konaiahgari-nithish-reddy/base_text/edge-firmware-BaseCode/README.md

# SmartTrak Project

## Task Todo
- [x] Create Bare-Metal USB-CDC Class
- [x] Implement USB-CDC with master codebase
- [x] Create WiFi-Mesh Project (Working)
  - [x] Implement Mesh Fail Cases
  - [x] Implement MQTT Connection with Cloud
  - [x] Implement JSON parser
  - [x] Merge with Main Parser CodeBase

## Remote monitoring and Control implemented 
- [x] Get All Status data like (inclinometer, Polar Axis SPA Tracking Moves, Sun Angles, Motion Sensor Register values, PWM Register values)
- [x] Set parameters present in utility section --> Set Params
- [x] Corrected tracker and target angle
