konaiahgari-nithish-reddy/base_text/edge-firmware-BaseCode/Resources/Docs/SmartTrak Solar Panel Controller Diagrams A06 (1).pdf

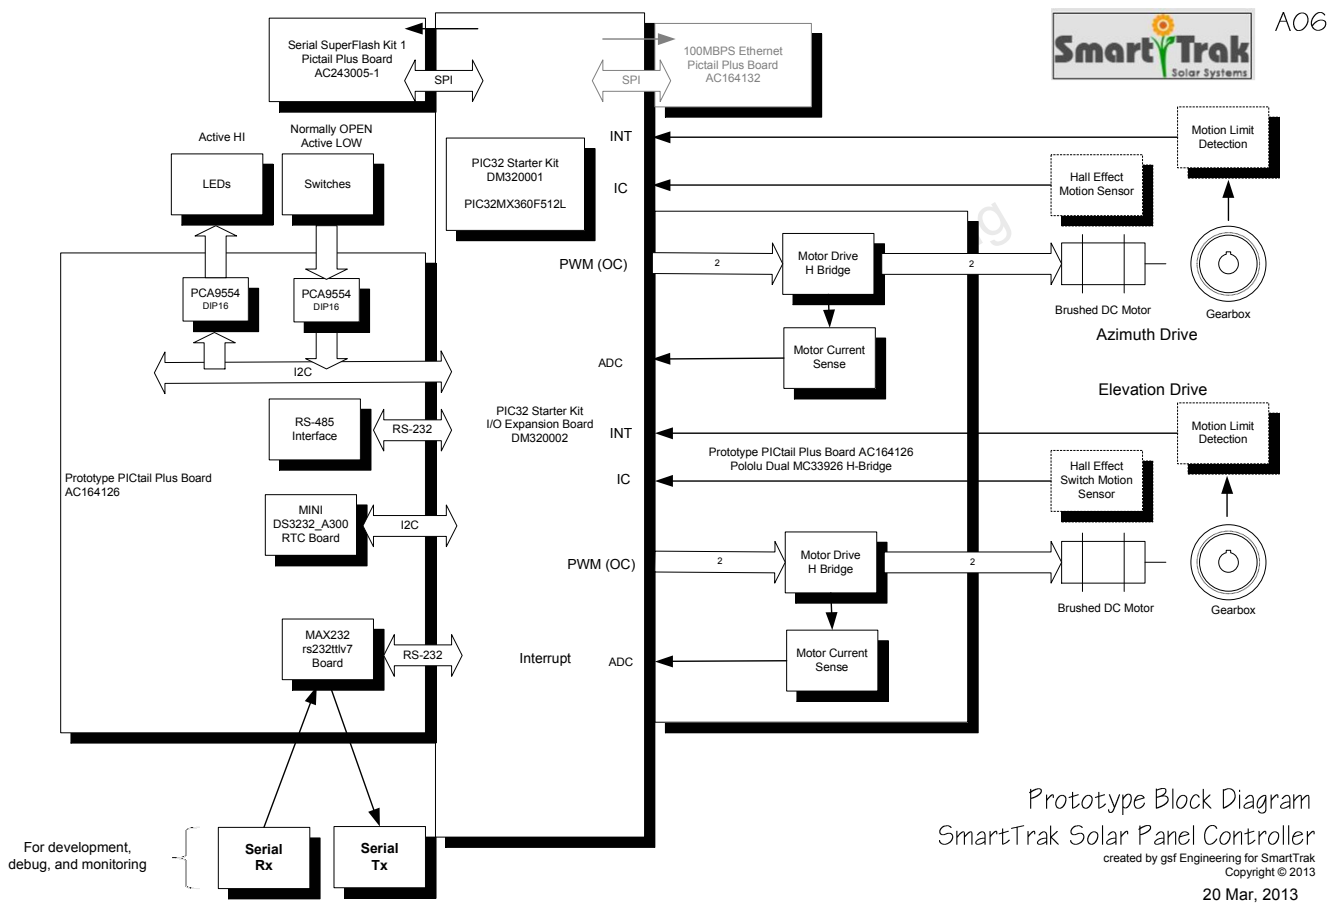
[picture p1: page 1]
20 Mar, 2013; Copyright © 2013; PIC32 Starter Kit I/O Expansion Board DM320002; Motor Drive H Bridge; Serial Rx; Serial Tx; Brushed DC Motor; Gearbox; Interrupt; Motor Current Sense; MAX232 rs232ttlv7 Board; Motion Limit Detection; ADC; Hall Effect Switch Motion Sensor; PWM (OC); Hall Effect Motion Sensor; PIC32 Starter Kit DM320001; PIC32MX360F512L; 100MBPS Ethernet Pictail Plus Board AC164132; MINI DS3232_A300 RTC Board; SPI; PCA9554; DIP16; Switches; LEDs; Normally OPEN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

Serial SuperFlash Kit 1
Pictail Plus Board

Confidential - Delete Before Reading

RS-232 RS-485 Interface

Prototype PICtail Plus Board AC164126
Pololu Dual MC33926 H-Bridge

Prototype PICtail Plus Board

For development,
debug, and monitoring

created by gsf Engineering for SmartTrak

# Confidential

# Delete Before Reading

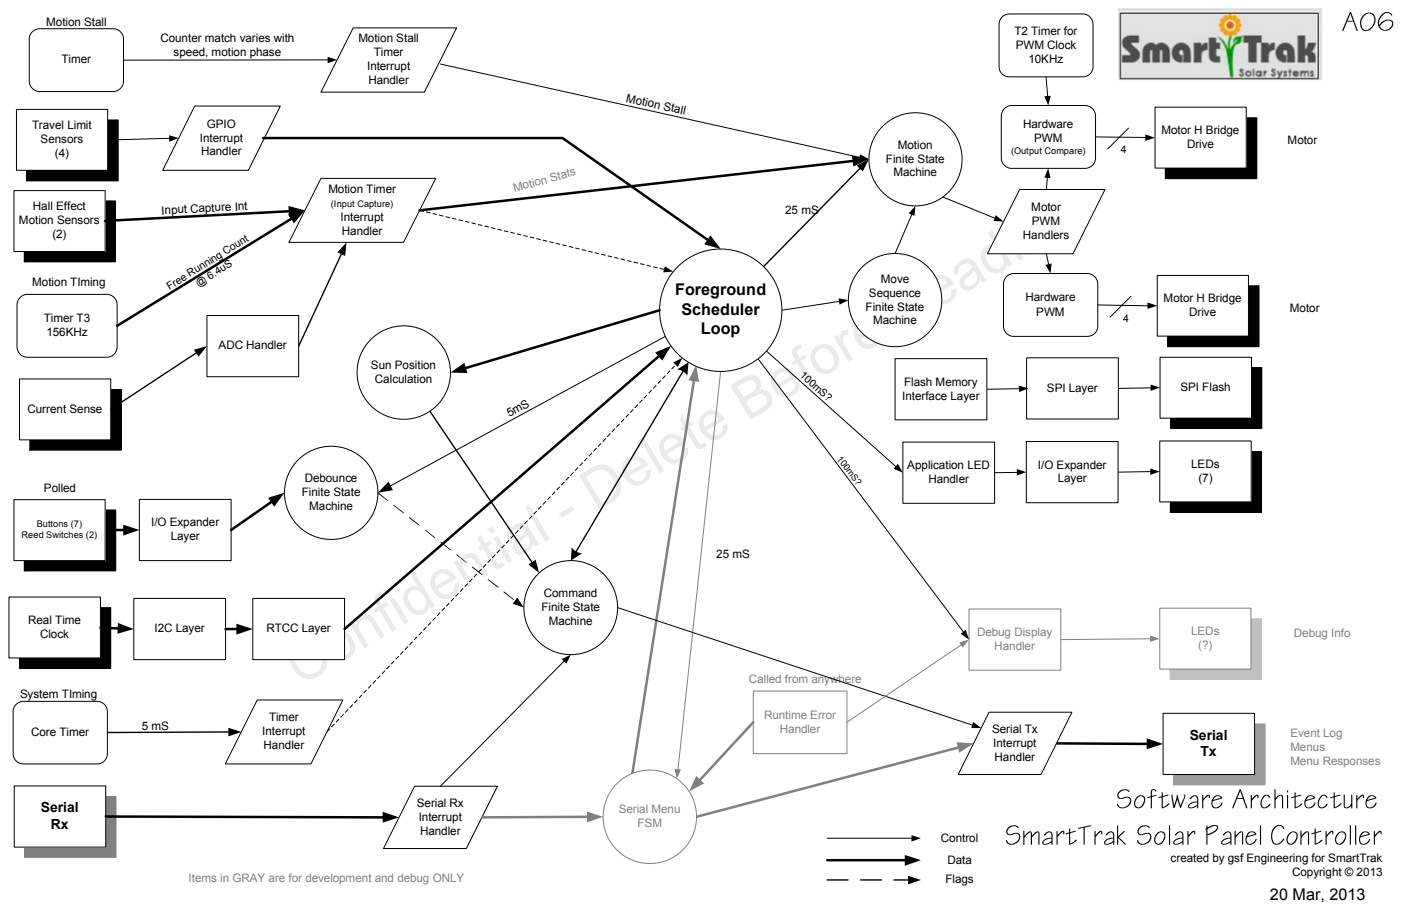
[picture p2: page 3]
Confidential; Motor H Bridge Drive; Timer T3 156KHz; LEDs (?); Debug Display; Debug Info; Handler; Data; Control; Flags; Debounce Finite State Machine; Buttons (7) Reed Switches (2); Core Timer; Timer Interrupt Handler; Hall Effect Motion Sensors (2); Motion Timer; (Input Capture) Interrupt Handler; pture Int; Motion Finite State Machine; Serial Rx Interrupt Handler; Serial Rx; Serial Tx; Event Log Menus Menu Responses; Hardware PWM; (Output Compare); Motor; Command Finite State Machine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

Counter match varies with
speed, motion phase

Delete Before Reading

Free Running Count

Called from anywhere

Items in GRAY are for development and debug ONLY

# Confidential - Delete Before Reading

Data

Control

Flags

Finite State
Machine

Interrupt
Handler

Internal
Hardware
Resource

External
Hardware

## Foreground Loop

Major Software
Routine (NOT FSM)

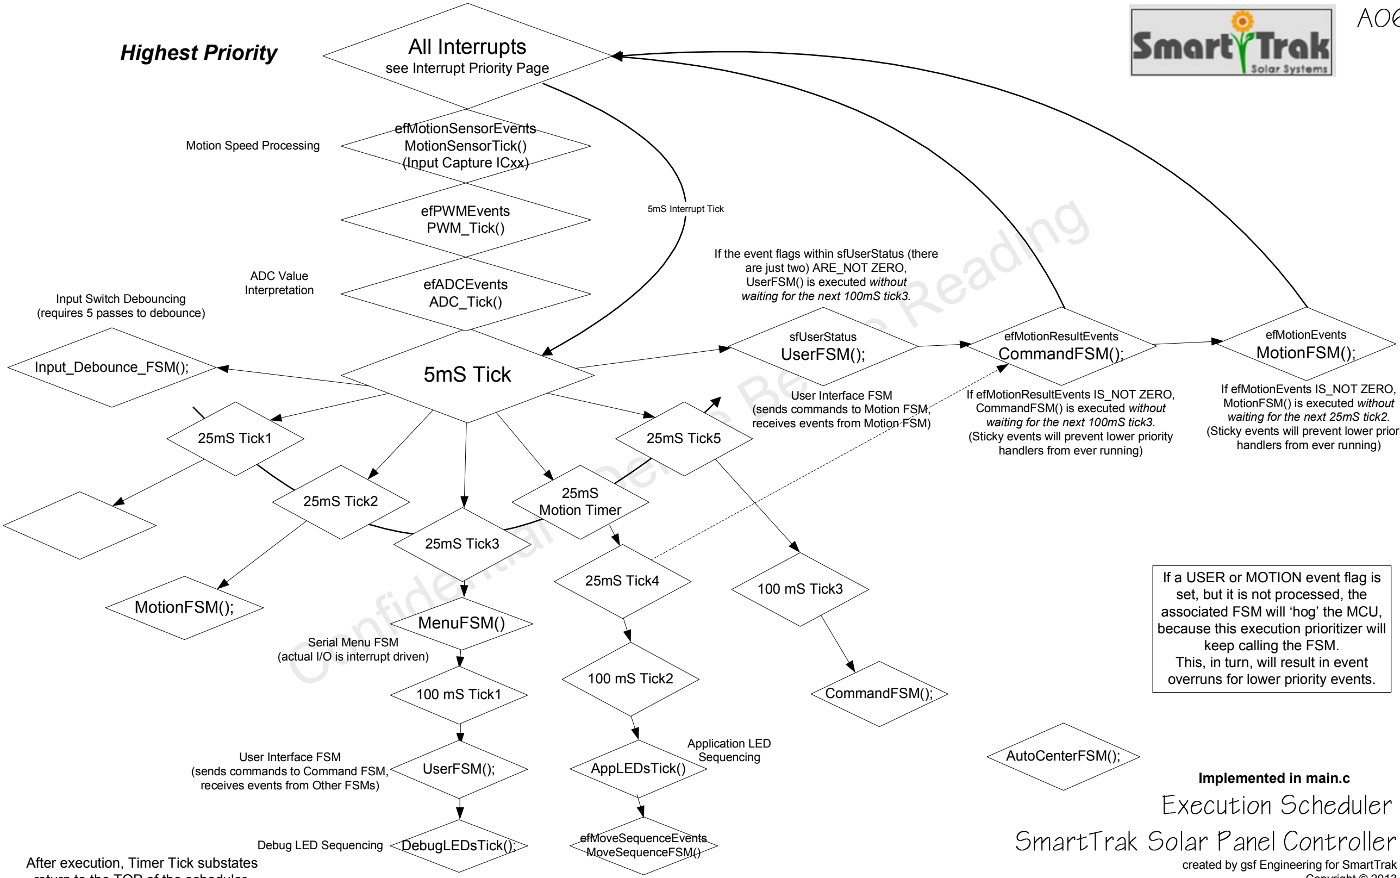
[picture p3: figure]
Confidential - Delete Before Reading; MenuFSM(); 5mS Tick; Serial Menu FSM (actual I/O is interrupt driven); 5mS Interrupt Tick; efADCEvents ADC_Tick(); efMotionEvents MotionFSM();; efMotionResultEvents CommandFSM();; ADC Value Interpretation; If efMotionEvents IS_NOT ZERO, MotionFSM() is executed without waiting for the next 25mS tick2.; handlers from ever running); If efMotionResultEvents IS_NOT ZERO, CommandFSM() is executed without waiting for the next 100mS tick3.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

Highest Priority | All Interrupts see Interrupt Priority Page

(Sticky events will prevent lower priority (Sticky events will prevent lower priority

return to the TOP of the scheduler.

If the event flags within sfUserStatus (there

# Confidential

# Delete Before Reading

STOPPED

Constant PWM
Constant Speed
‘Run’
STOPPED Increase PWM Accelerate | Decrease PWM Decelerate

Decrease
PWM
(Run)

HE Time
Too Short

At Target Speed,
(Maximum PWM)
OR
HE Count Complete

Accelerate Command

Total Motion Sensor Ticks required for requested Move

Total Motion Sensor Ticks required for requested Move MINUS Ticks required for Deceleration and STOP

Constant Speed
Motion Complete
(HE Count Complete)

Motion Complete
(HE Count Complete)

Move Specification:
Distance in Motion Sensor Ticks
Maximum (constant) Speed, not a variable

Input Parameters:
PWM Width

Measured Ouputs:
Time between Motion Sensor ticks (Speed)

Decrease
PWM
(Acceleration)

HE Time
Too Short

Hard STALL

Minimum PWM
Constant Speed

Minimum PWM
Stalled

Minimum PWM
Stalled

Minimum
PWM

Motion Stall
Stalled

Motion NOT Complete Acceleration NOT

Complete
Constant Speed Motion
NOT Complete

Deceleration to Minimum PWM NOT Complete

### Speed

FSM Parameters:
Initial PWM width
Acceleration in PWM width change per timer interrupt
Number of Motion Sensorticks during acceleration (may not be enough to reach max speed)
(Needs to account for current travel limit)
Final PWM width at end of acceleration (maximum PWM)
Number of Motion Sensor ticks during constant speed (may be 0) (Needs to account for travel limit)
Deceleration in PWM width change per timer interrupt
Number of Motion Sensor ticks during deceleration
(Needs to account for travel limit)
Minimum PWM width at end of deceleration

External FSM Events
New Motion Command

Init

Initialization

Increase PWM
(Acceleration)

HE Time
Too Long

Increase PWM
(Run)

HE Time
Too Long

Recovered,
At End Stop

Stalled - ERROR

### States shown in GREEN are the actual motion control code, which

corrects motion (speed) errors.

### Implemented in MotionFSM.c

No Constant Speed
Run Phase

Coasting
Braking | Motion Stall

Motion Complete
(HE Count Complete)

Soft STALL
FSM

Motion Stall
OR
Maximum PWM

Motion Stall
Stalled

Motion Stall
Stalled

Motion Stall
Stalled

Note: we cannot detect the end-stop during Coasting/
Braking because the
ONLY exit from the state
is.. A MOTION_STALL!

Note that there are no motion control adjustment states for Deceleration

Notes:
Speed is measured by timing Motion Sensor Ticks
Distance is measured by counting Motion Sensor Ticks
To bring about a controlled stop at ANY time, change the number of Ticks to Move to ZERO

Initial (minimum) PWM value must be determined
experimentally

Total Motion Sensor Ticks required for requested Move

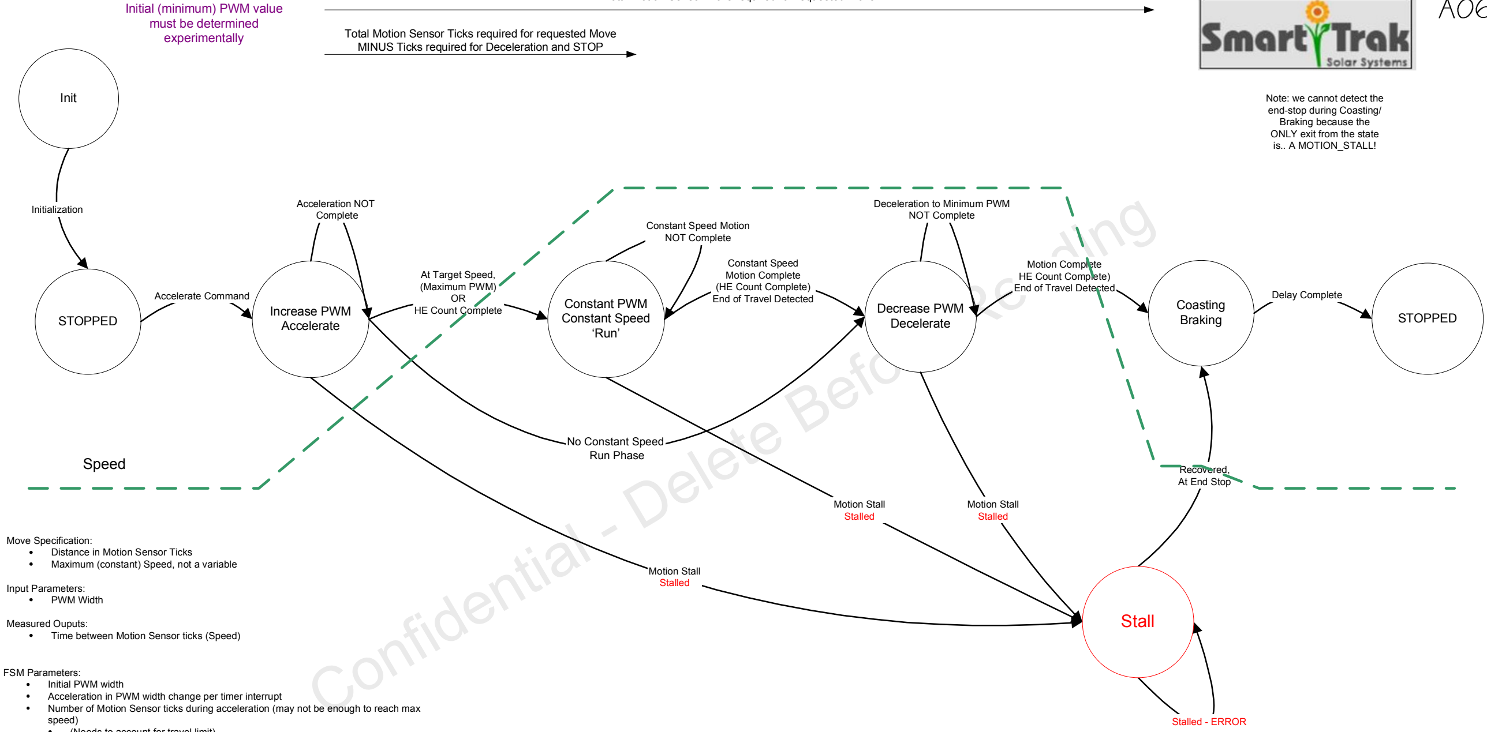
[picture p4: figure]
Confidential - Delete Before Reading; STOPPED; Constant PWM Constant Speed ‘Run’; STOPPED Increase PWM Accelerate; Decrease PWM Decelerate; At Target Speed, (Maximum PWM) OR HE Count Complete; Accelerate Command; Constant Speed Motion Complete (HE Count Complete) End of Travel Detected; Move Specification: Distance in Motion Sensor Ticks; Input Parameters: PWM Width; Measured Ouputs:; Acceleration NOT Complete; Constant Speed Motion NOT Complete; Deceleration to Minimum PWM NOT Complete; Speed; FSM Parameters: Initial PWM width; speed); Init; Initialization; Recovered, At End Stop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

Total Motion Sensor Ticks required for requested Move MINUS Ticks required for Deceleration and STOP

Maximum (constant) Speed, not a variable

Time between Motion Sensor ticks (Speed)

Notes:
Speed is measured by timing Motion Sensor Ticks
Distance is measured by counting Motion Sensor Ticks
To bring about a controlled stop at ANY time, change the number of Ticks to Move to ZERO

Acceleration in PWM width change per timer interrupt
Number of Motion Sensor ticks during acceleration (may not be enough to reach max

(Needs to account for travel limit)
Final PWM width at end of acceleration (maximum PWM)
Number of Motion Sensor ticks during constant speed (may be 0) (Needs to account for travel limit)
Deceleration in PWM width change per timer interrupt
Number of Motion Sensor ticks during deceleration
(Needs to account for travel limit)
Minimum PWM width at end of deceleration

External FSM Events
New Motion Command

### Implemented in MotionFSM.c

# Confidential - Delete Before Reading

### Acceleration

### Deceleration (¼ acceleration distance)

Constant Speed ‘Run’

## Long Move

## shortest Possible Move

Coast Brake

Stopped

# Speed

# Distance

# NOT TO SCALE!

## Shortest Useful Move

## Run to End-of-Travel

### Ends with End-of-Travel Detection

Coast

Brake Stopped

### Deceleration (¼ acceleration distance)

Coast

Brake Stopped

### Deceleration (¼ acceleration distance)

### Acceleration

### Acceleration

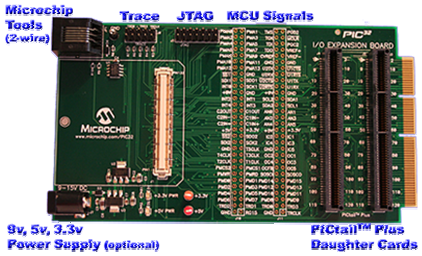
[picture p5: figure]
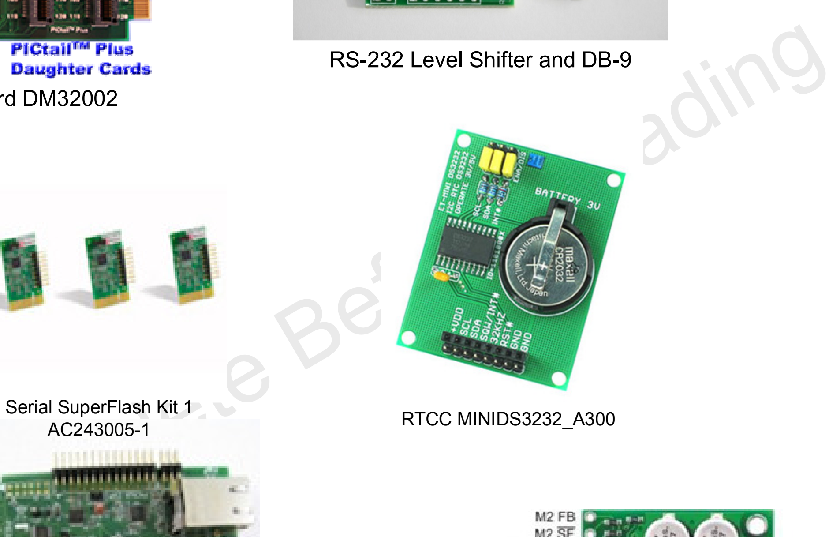
[picture p6: figure]
Delete Before Reading; RS-232 Level Shifter and DB-9; Serial SuperFlash Kit 1 AC243005-1; RTCC MINIDS3232_A300
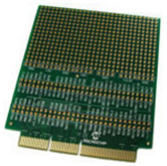
[picture p7: figure]
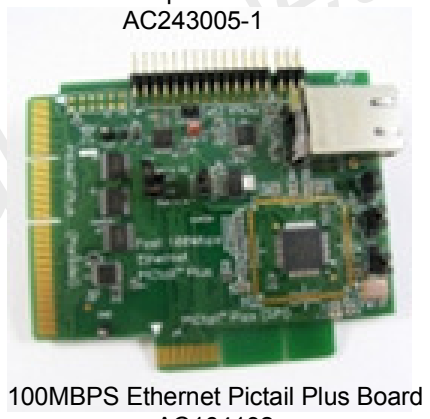
[picture p8: figure]
100MBPS Ethernet Pictail Plus Board

# Confidential

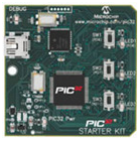
[picture p9: figure]

### PIC32 Starter Kit DM32001 PIC32 Starter Kit I/O Expansion Board DM32002

Prototype PICtail Plus Board
AC164126

AC164132

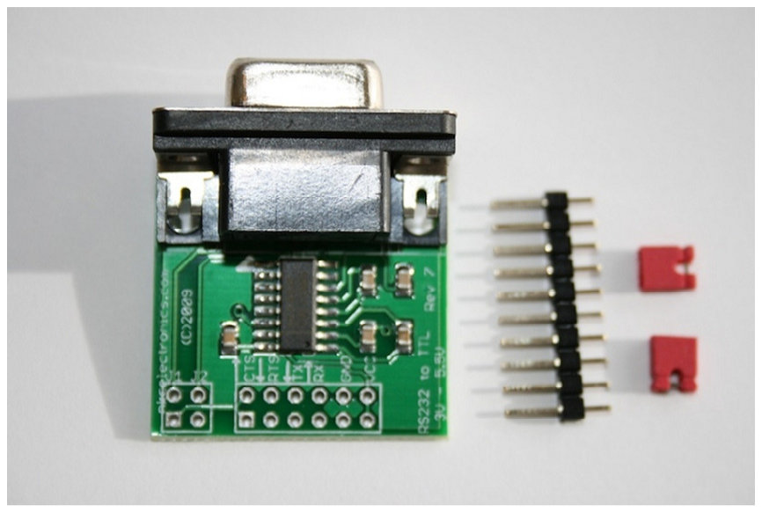
[picture p10: figure]
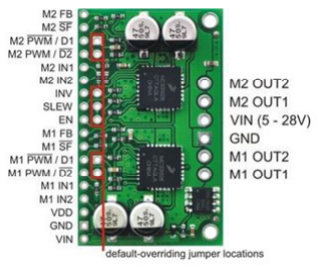
[picture p11: figure]

### Pololu Dual MC33926 H-Bridge

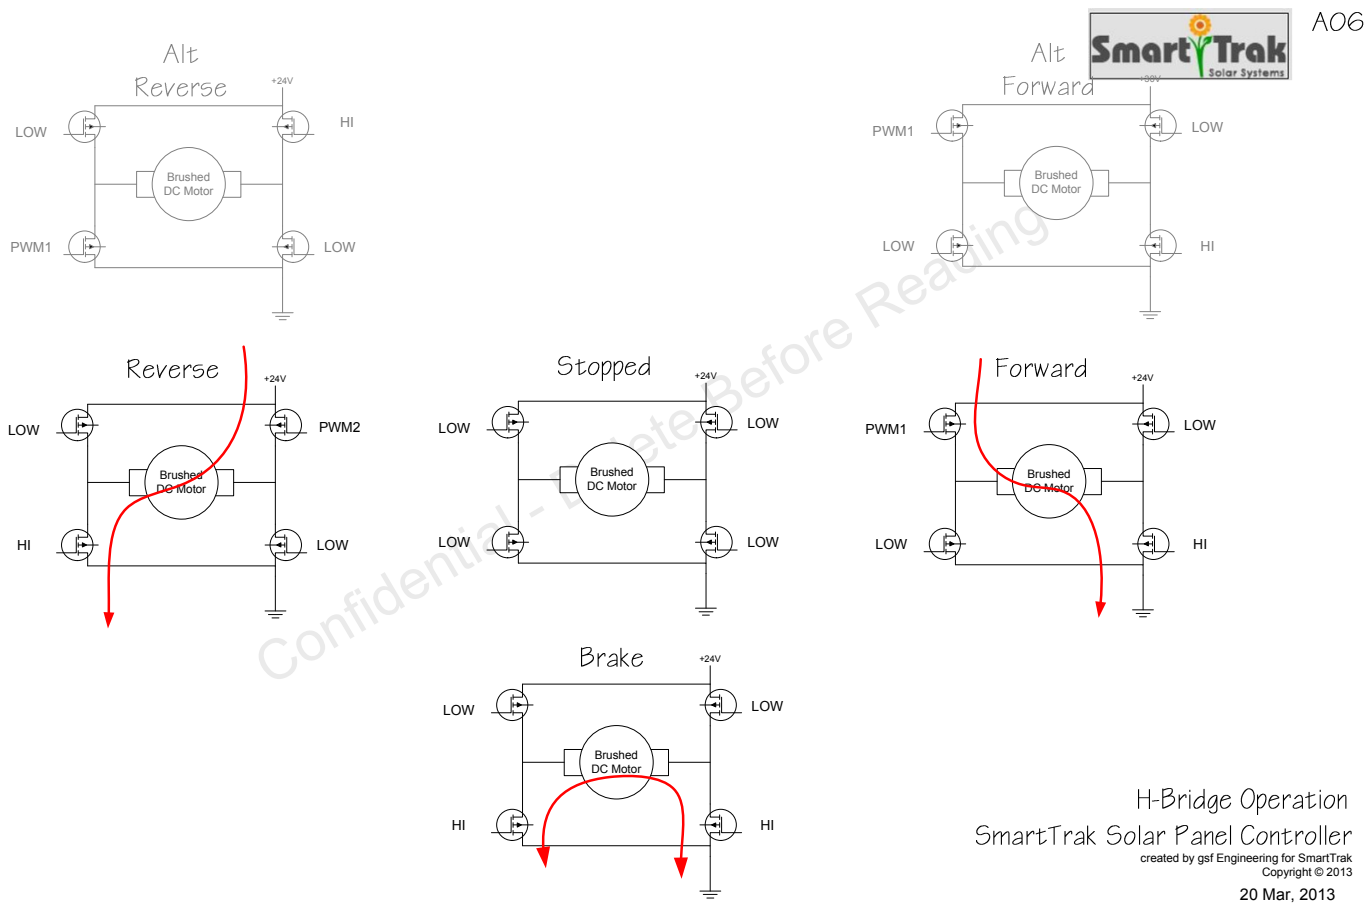
[picture p12: page 10]
Brushed DC Motor; LOW; PWM2; PWM1

Confidential - Delete Before Reading

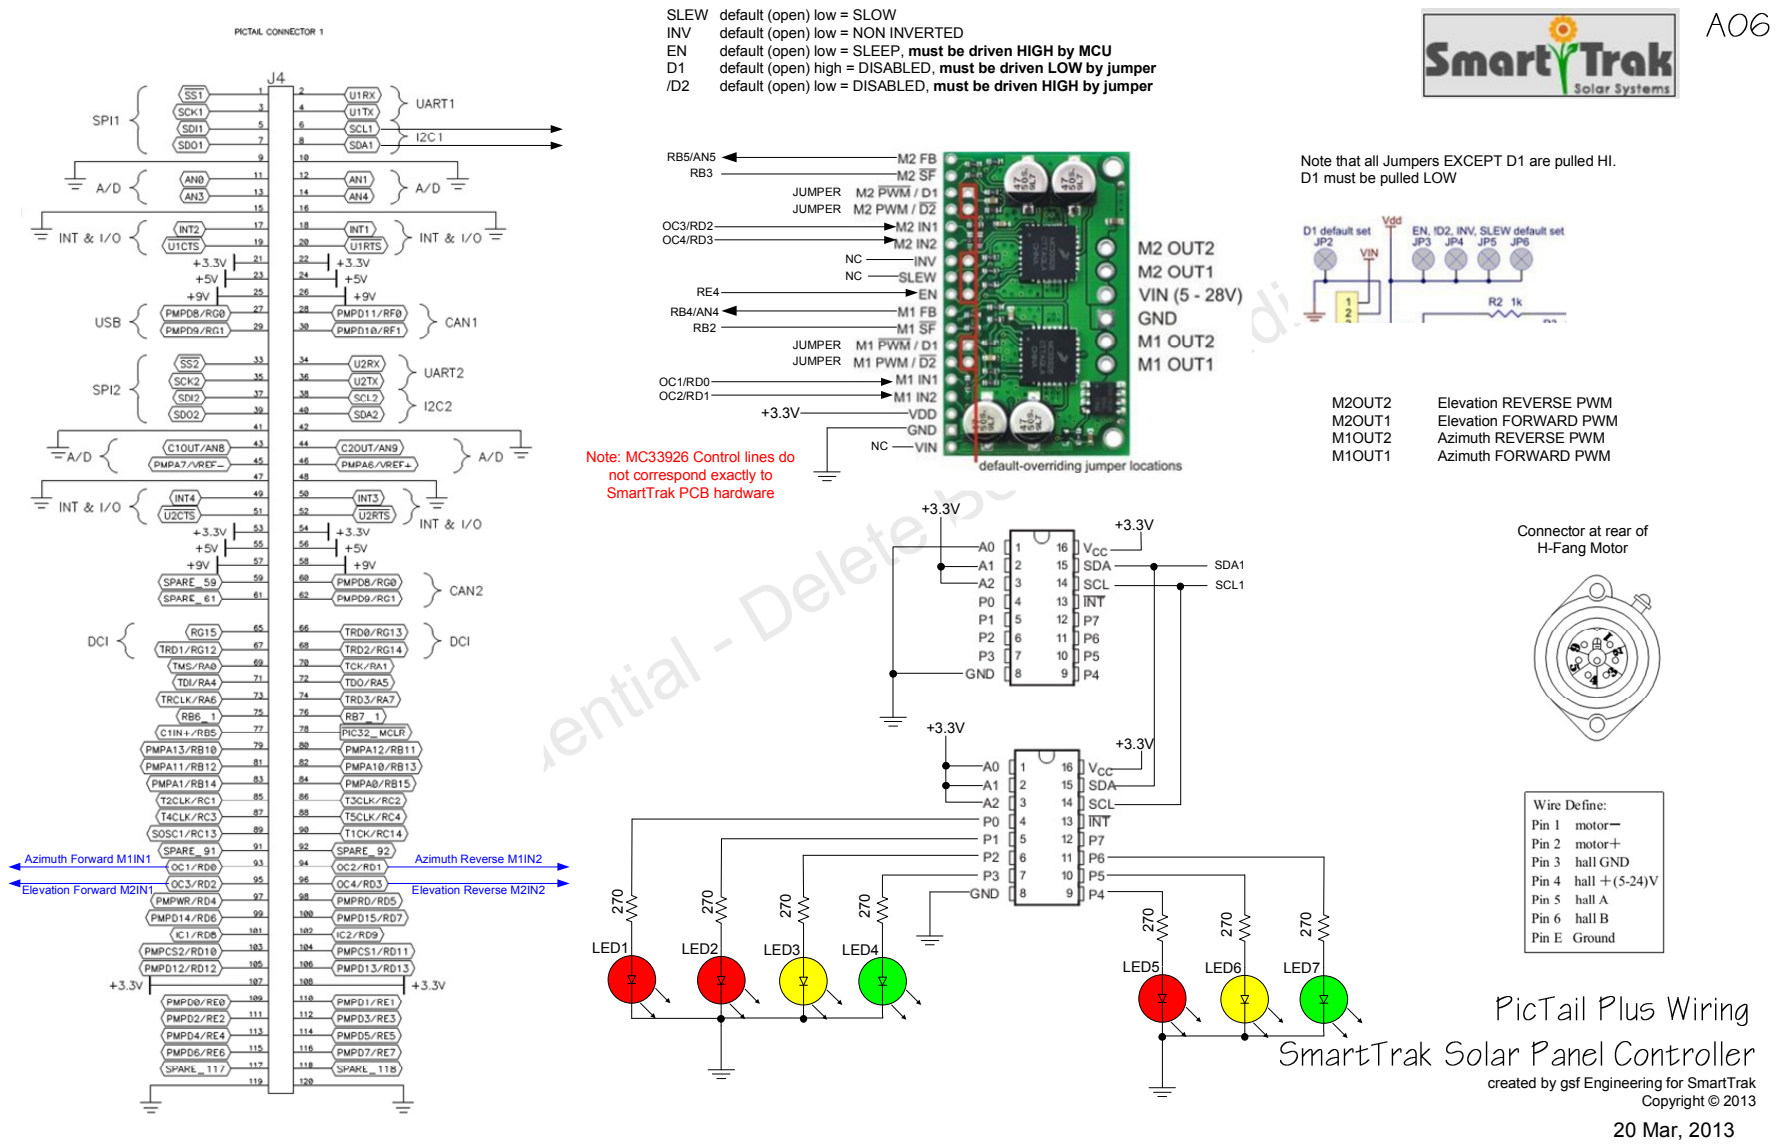
[picture p13: page 11]

SLEW default (open) low = SLOW

Note that all Jumpers EXCEPT D1 are pulled HI.
D1 must be pulled LOW

Confidential - Delete Before Reading

Note: MC33926 Control lines do
not correspond exactly to
SmartTrak PCB hardware

Connector at rear of
H-Fang Motor

Note that all Jumpers EXCEPT D1 are pulled HI. D1 must be pulled LOW

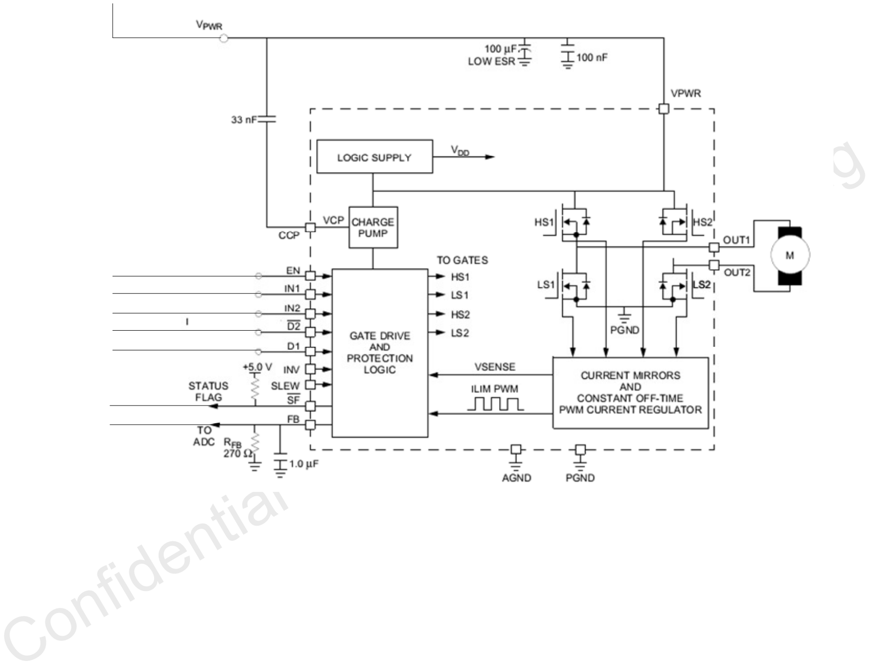
[picture p14: figure]
Confidential - Delete Before Reading
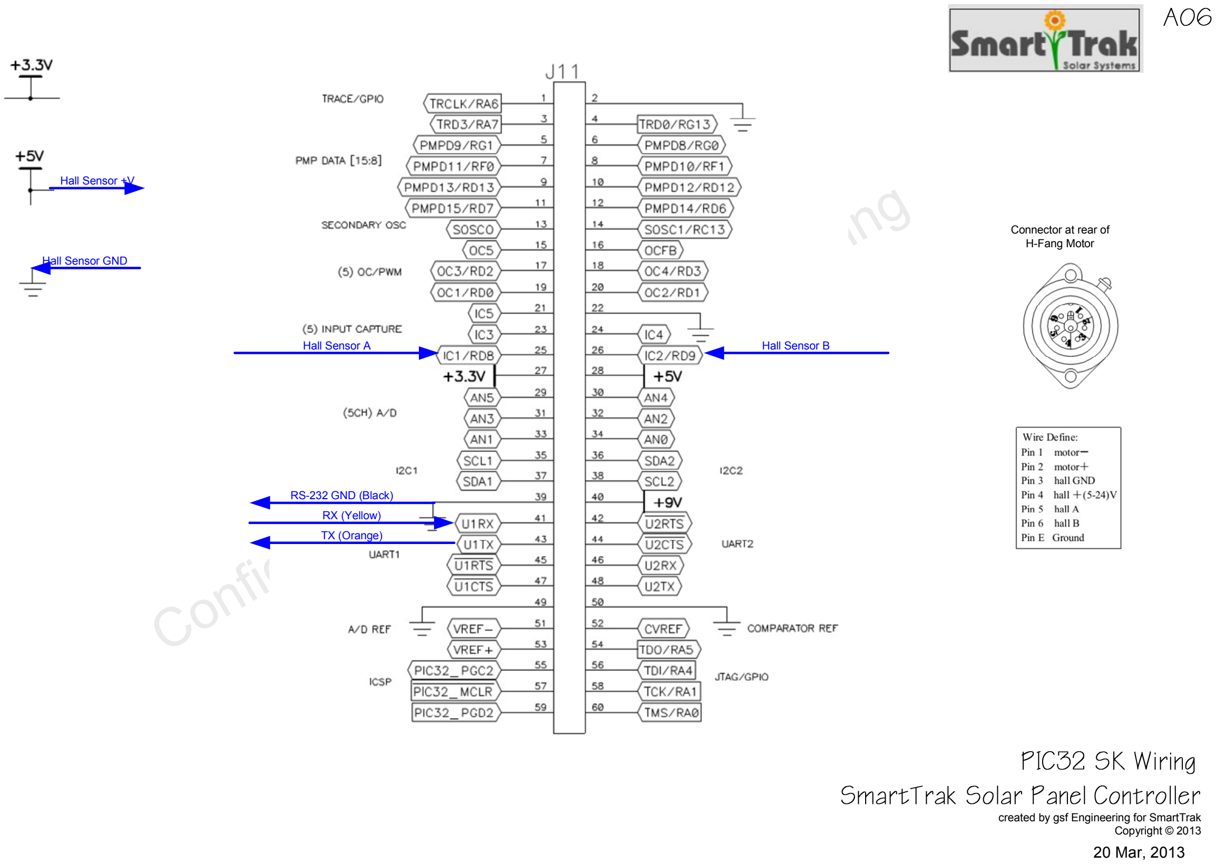
[picture p15: page 13]

# Confidential

# Delete Before Reading

TX (Orange)

RX (Yellow)

RS-232 GND (Black)

Hall Sensor A | Hall Sensor B

Hall Sensor +V

Hall Sensor GND

Connector at rear of
H-Fang Motor

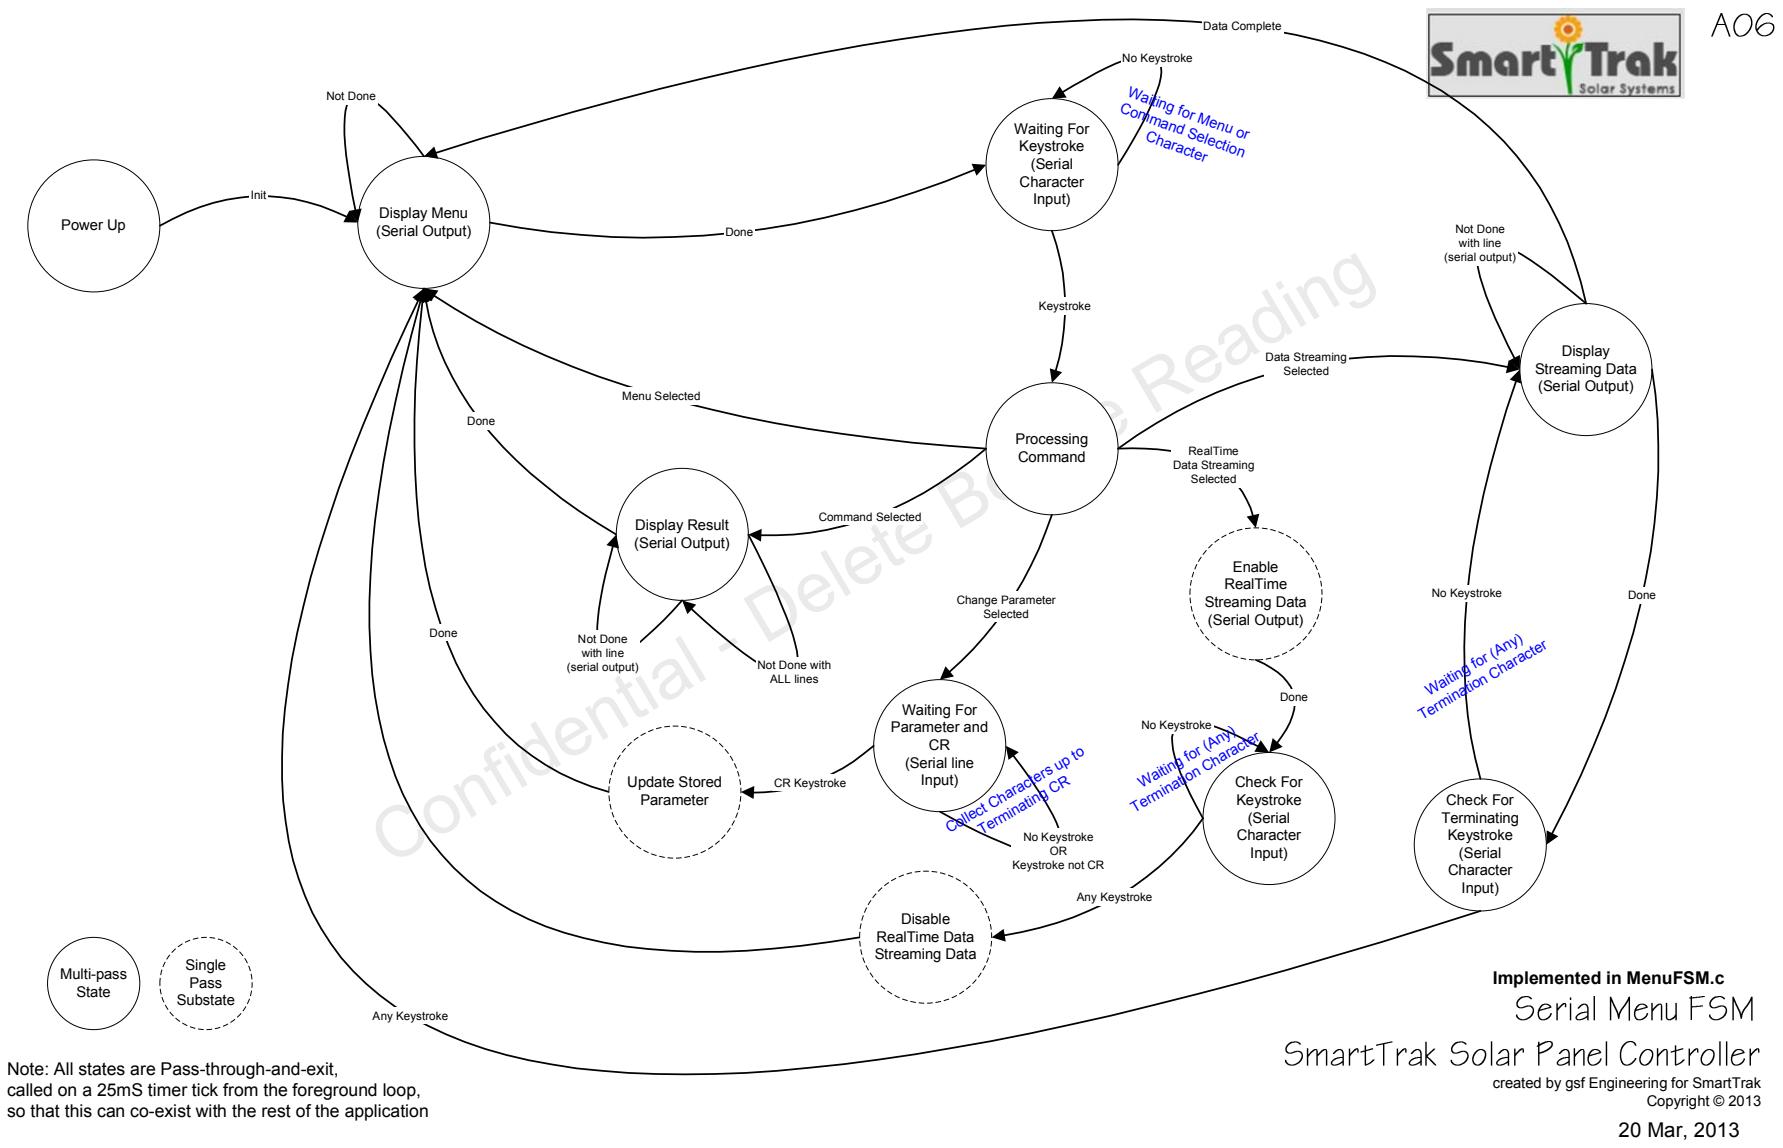
[picture p16: page 14]
Power Up; Display Menu (Serial Output); Waiting For Keystroke (Serial Character Input); Waiting For Parameter and CR (Serial line Input); Processing Command; Init; Done; No Keystroke; Menu Selected; Keystroke; No Keystroke OR; Change Parameter Selected; Not Done; Display Result (Serial Output); Not Done with line (serial output); Command Selected; Data Streaming Selected; Check For Terminating Keystroke (Serial Character Input); Display Streaming Data (Serial Output); Any Keystroke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

Waiting for Menu or Command Selection Character

Confidential - Delete Before Reading

Waiting for (Any)

Not Done with
ALL lines

Collect Characters up to Terminating CR

Keystroke not CR

Implemented in MenuFSM.c

Note: All states are Pass-through-and-exit,
called on a 25mS timer tick from the foreground loop,
so that this can co-exist with the rest of the application

# Confidential

# Delete Before Reading

### Planetary Gearbox

575:1

Max Motor Gearbox Velocity: 18.8 degrees/sec 30 motor revolutions/sec (1800 RPM) 3.13 output shaft revolutions/min (1127 degrees/min) 0.0522 output shaft revolutions/sec (18.8 degrees/sec) 60 Motion Sensor ticks/sec 16.7mS per Sensor tick (0.31 degrees/tick) TMR3 = (80MHz/2)/256, 156KHz, 6.40uS/count 5219 TMR3 counts per Motion Sensor tick Max Acceleration: x.xxx degrees/s/s assuming linear acceleration from 0 to x.xxx degrees/s/s x.xx shaft revolutions xx.x motor revolutions xxxx Motion Sensor ticks

### Motion Sensor (Hall Effect) 2 ticks per MOTOR revolution

1.00 degree Total Motion: 0.0028 output shaft revolutions 0.2028 input shaft revolutions 116.6 motor revolutions 233.2 motion sensor ticks 0.065 minutes, 3.89S at maximum speed (no accel or decel) Minimum motion 0.00429 degrees 0.5 motor revolutions 1 Motion Sensor tick TOTAL Longest Motion Sensor tick timing: accelerating from 0 at 9.4 degrees/s/s using d = 0.5 * a * t ^2, for d = 4.7 degrees, t = 1.0S xxxxx TMR3 counts per motion sensor tick xx.xx times longer than the 16.7mS tick at max spee

d

### this time, which is not entirely accurate because we will start with at least 20% duty cycle, will nonetheless be used to

determine the maximum motion timeout value

### Motor Kv 83 rpm/V (Measured) No Load 1800 RPM

0.0028 Output Shaft Revolutions Motion Profile 233 Motion Sensor Wheel ticks TOTAL 58 ticks accelerating from 0 at 9.4 degrees/s/s using d = 0.5 * a * t ^2, for d = 4.7 degrees, t = 1.0S 58 ticks decelerating at 2.35 degrees/s/s (1:4) using d = 0.5 * a * t ^2, for d = 4.7 degrees, t = 2.0S 117 ticks at full speed, 16.7mS per tick

t = 1.95S

### for a total 4.95S move observed x.xxS move starting at 20% duty cycle

Note: these timing calculations are based on starting motion at 0% PWM, and ramping up from there.
In reality, we will start the PWM will be started at 20% (or higher), which makes the calculations more complicated, and better done with a spreadsheet - but this method of calculation provides worst-case timing.

# Mechanical Characteristics Travel Limits:

### PWM is set by a 16 bit value, so the PWM can

be adjusted on every Motion Sensor tick.

### PWM drive at 10KHz (arbitrarily selected) Starting PWM value 20%, based on prior experience

### 1.00 Degree Move (This is an example, final specs not determined)

### Slew Gearbox

73:1

### Total Required Motion 16 Degrees/hour 16 x 1.0 Degree Move 16 x 4.95S = 79.2S in a 3600S hour

# To Be Corrected from Spreasheet
