konaiahgari-nithish-reddy/base_text/edge-firmware-BaseCode/Resources/Docs/NDA and Requirement/9-1_tracker-details.png

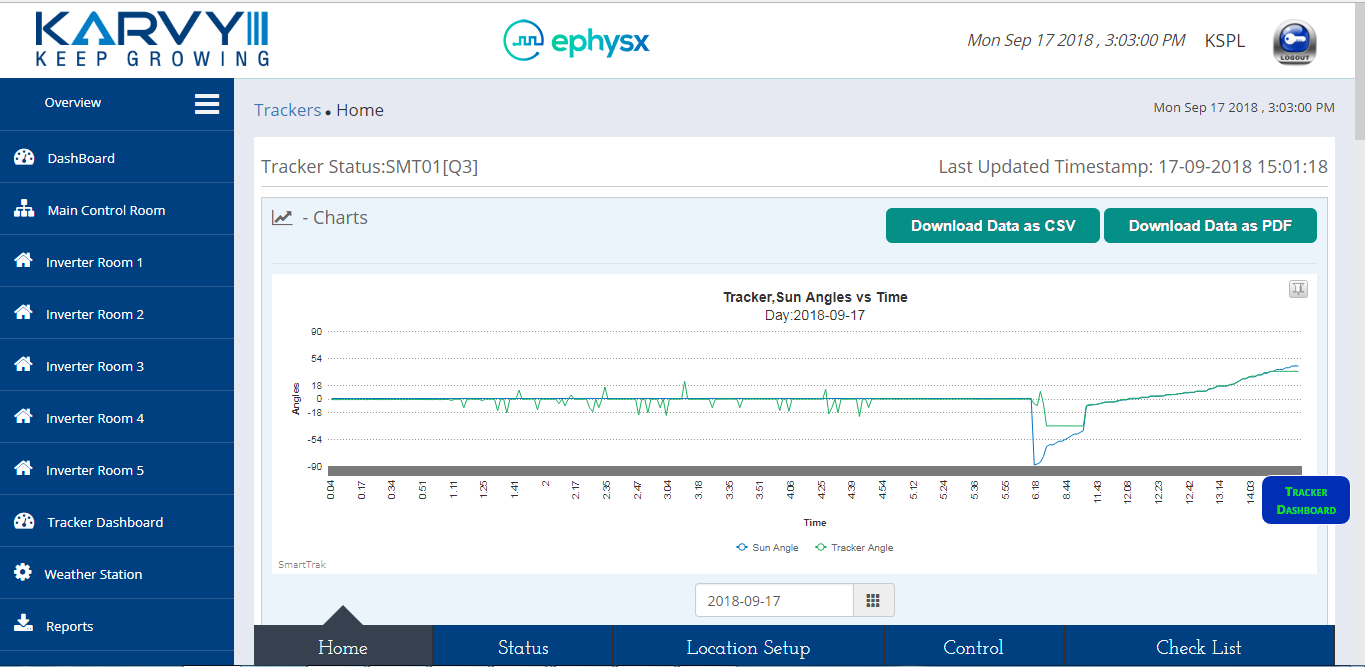
edge-firmware-BaseCode/Resources/Docs/NDA and Requirement/9-1_tracker-details.png
