konaiahgari-nithish-reddy/base_text/edge-firmware-BaseCode/Resources/Docs/NDA and Requirement/9-2_tracker-status.png

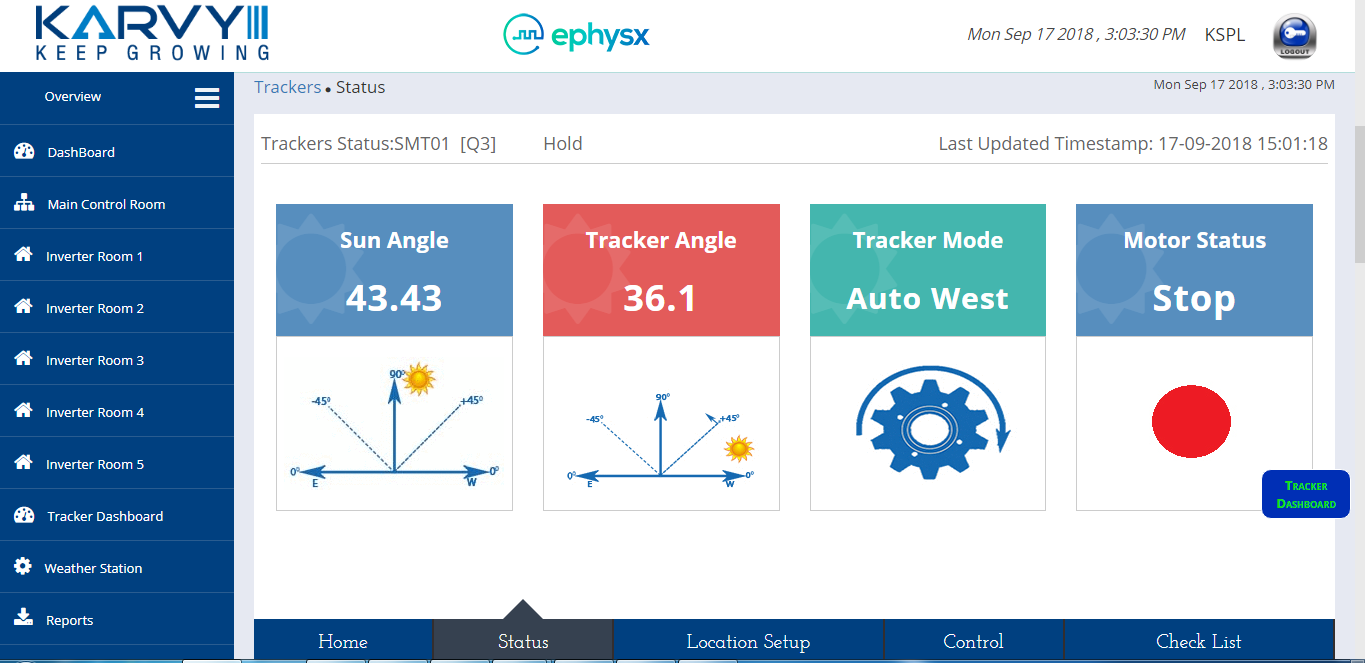
edge-firmware-BaseCode/Resources/Docs/NDA and Requirement/9-2_tracker-status.png
