konaiahgari-nithish-reddy/base_text/edge-firmware-BaseCode/Resources/Docs/NDA and Requirement/9-4_tracker-control.png

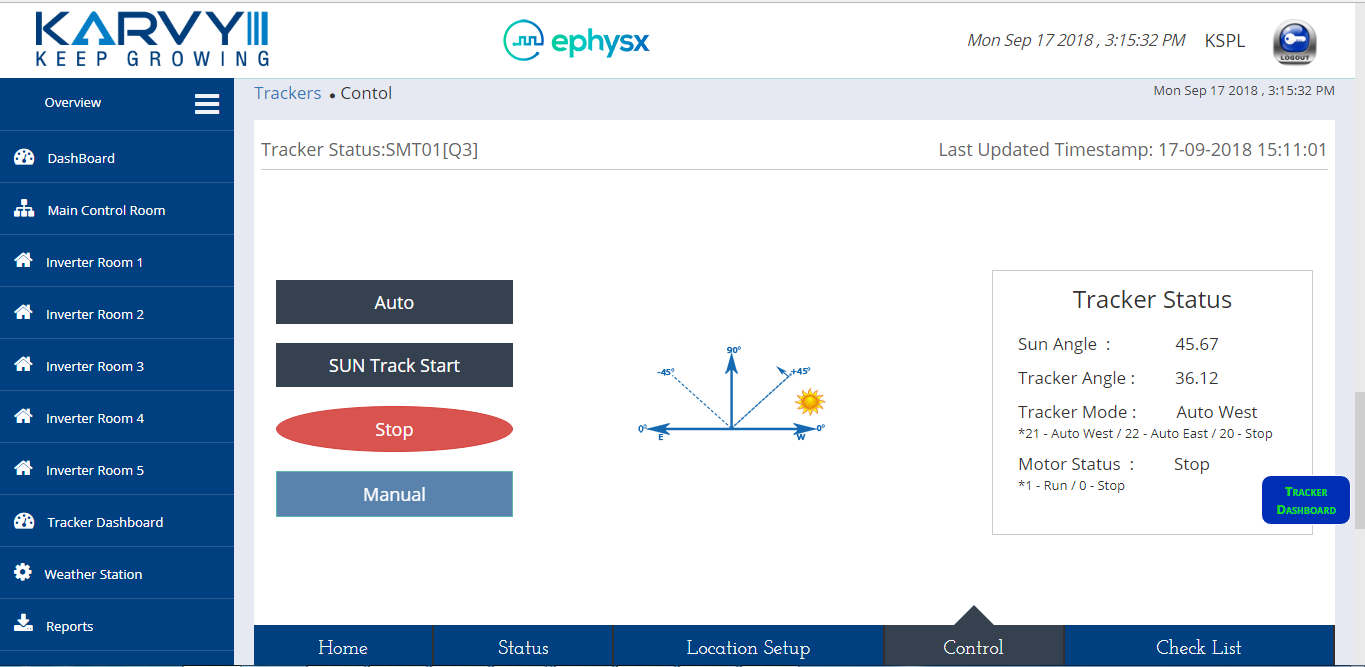
edge-firmware-BaseCode/Resources/Docs/NDA and Requirement/9-4_tracker-control.png
