konaiahgari-nithish-reddy/base_text/edge-firmware-BaseCode/Resources/Docs/NDA and Requirement/9_trackers_details.png

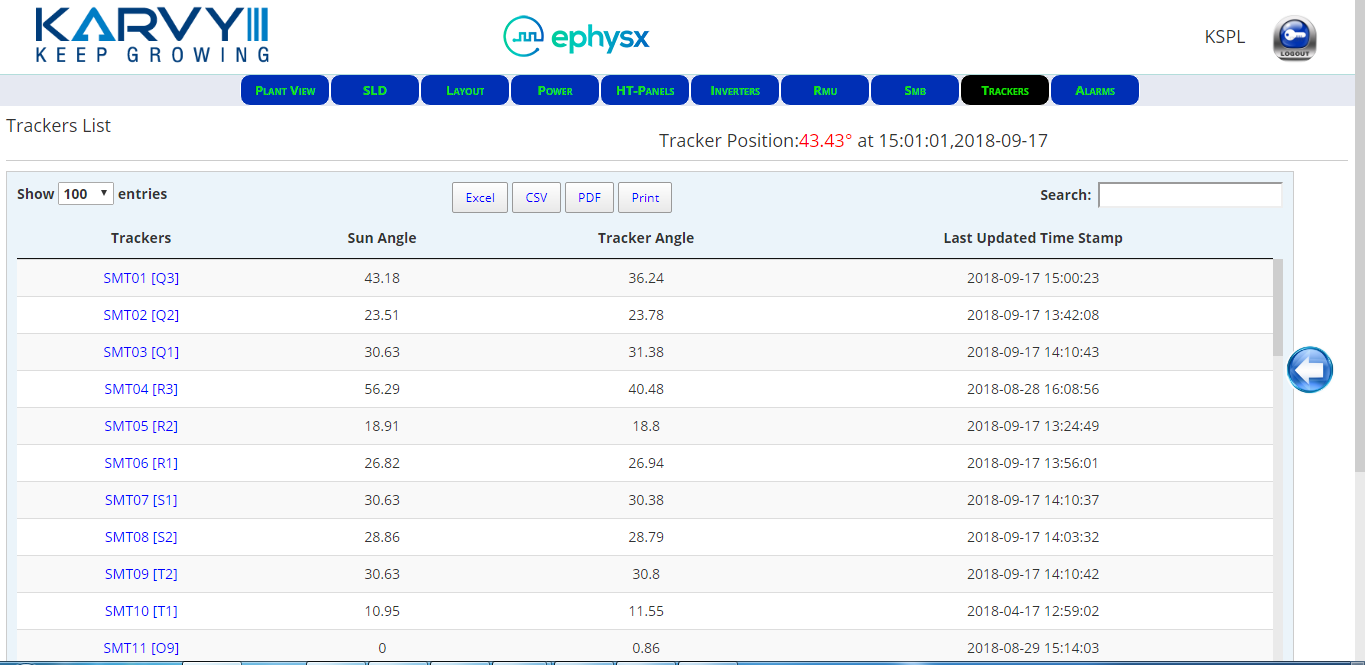
edge-firmware-BaseCode/Resources/Docs/NDA and Requirement/9_trackers_details.png
