konaiahgari-nithish-reddy/base_text/edge-firmware-BaseCode/Resources/Docs/USB_Device_initialization_main_functions_call_graph.png

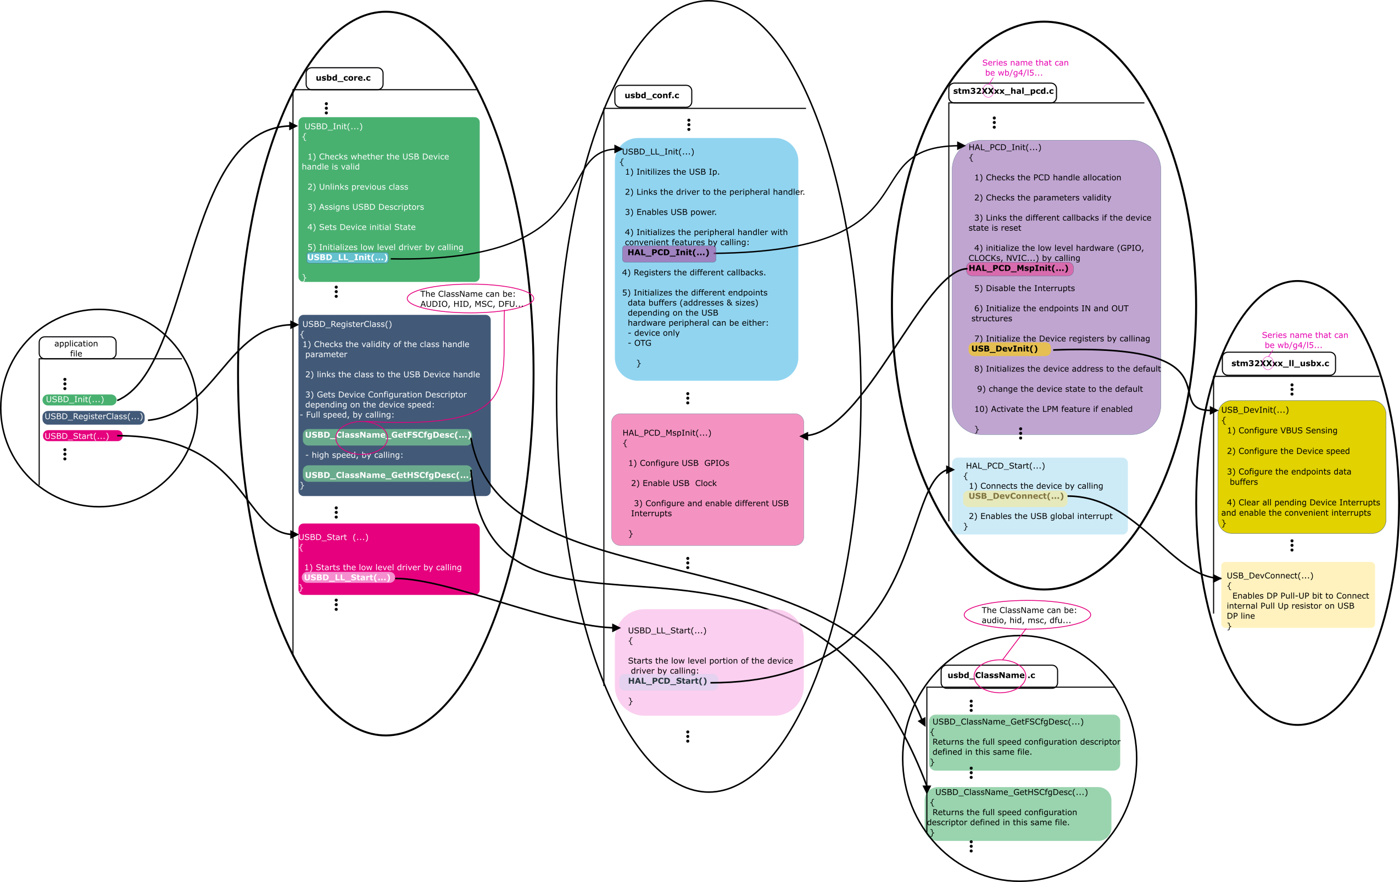
edge-firmware-BaseCode/Resources/Docs/USB_Device_initialization_main_functions_call_graph.png
