konaiahgari-nithish-reddy/base_text/edge-firmware-BaseCode/Resources/Docs/NDA and Requirement/9-3_tracker-location-setup.png

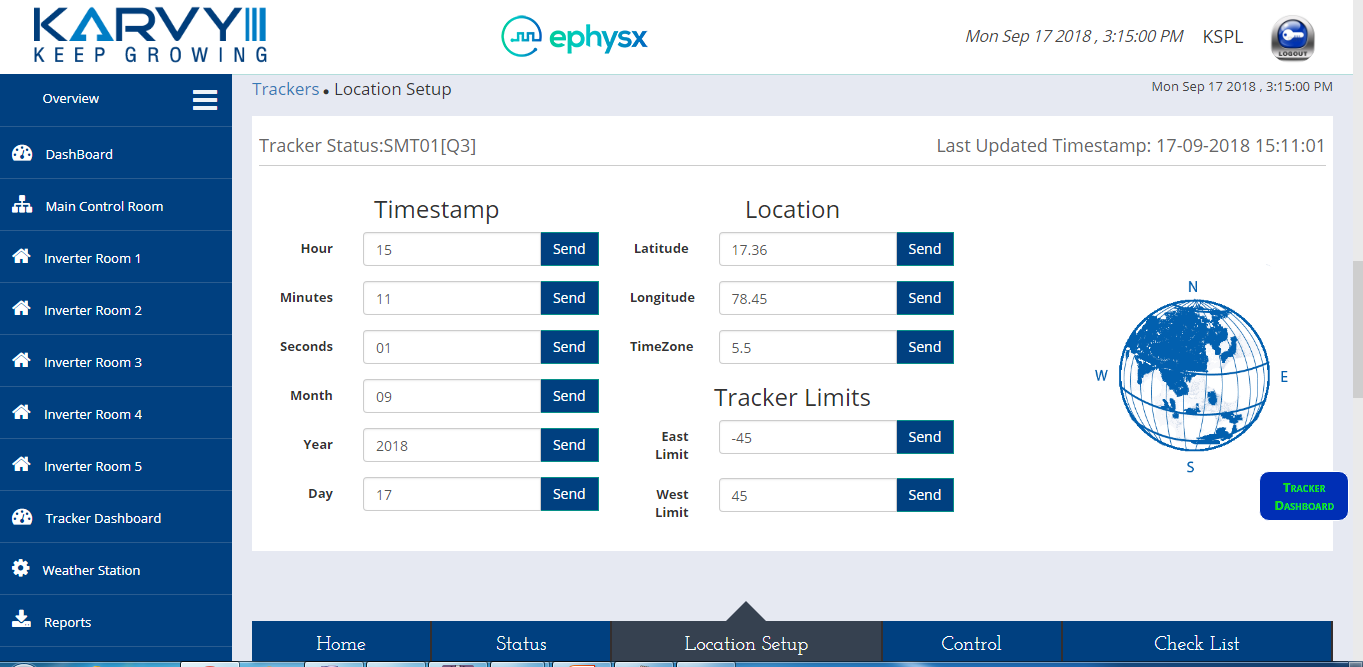
edge-firmware-BaseCode/Resources/Docs/NDA and Requirement/9-3_tracker-location-setup.png
