konaiahgari-nithish-reddy/base_text/edge-firmware-BaseCode/Resources/Schematic_Rev1.1.PDF

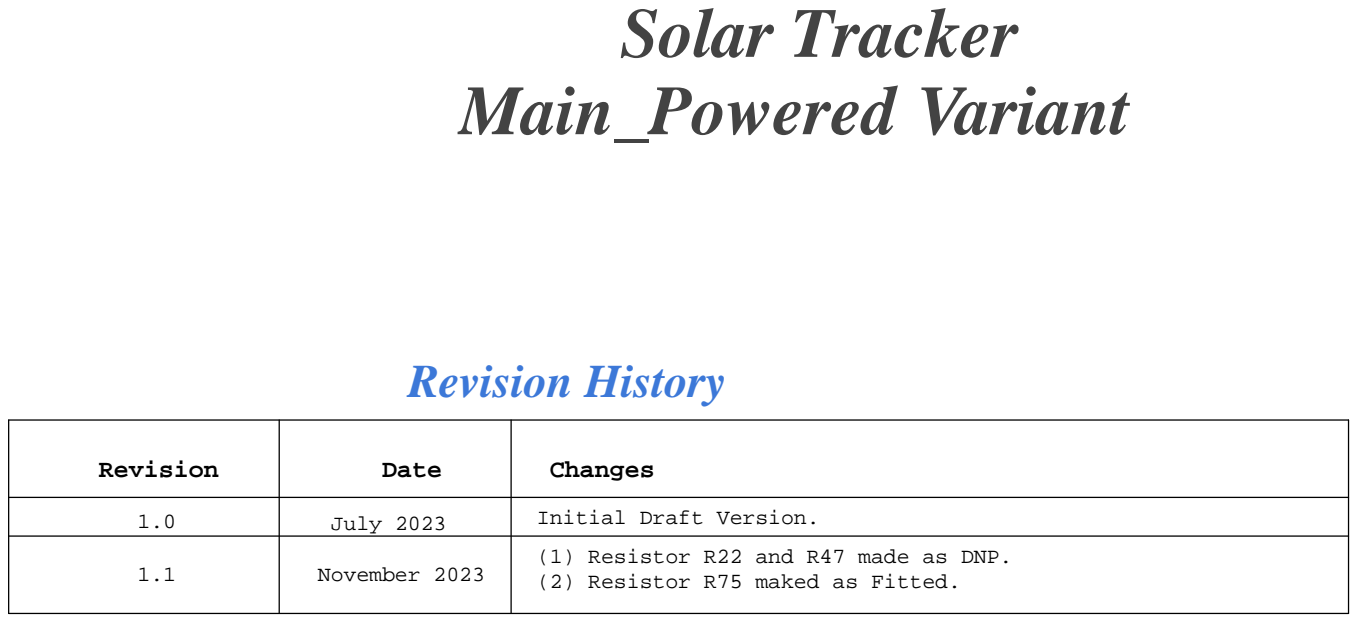
[picture p23: page 1]

Revision | Date | Changes

1.0 | July 2023 | Initial Draft Version.

1.1 | November 2023 | (1) Resistor R22 and R47 made as DNP. (2) Resistor R75 maked as Fitted.

Cannot open file E:\Bhaghavan - Smart
Trak\2.
Design\Variant-1\V0.1\Schematic
Template\smarttrak-logo.png. File does
not exist.

Sheet Title 01_REVISION_HISTORY.SchDoc

Size A3 | Rev: 1.0 | Date: 04-11-2023 Sheet

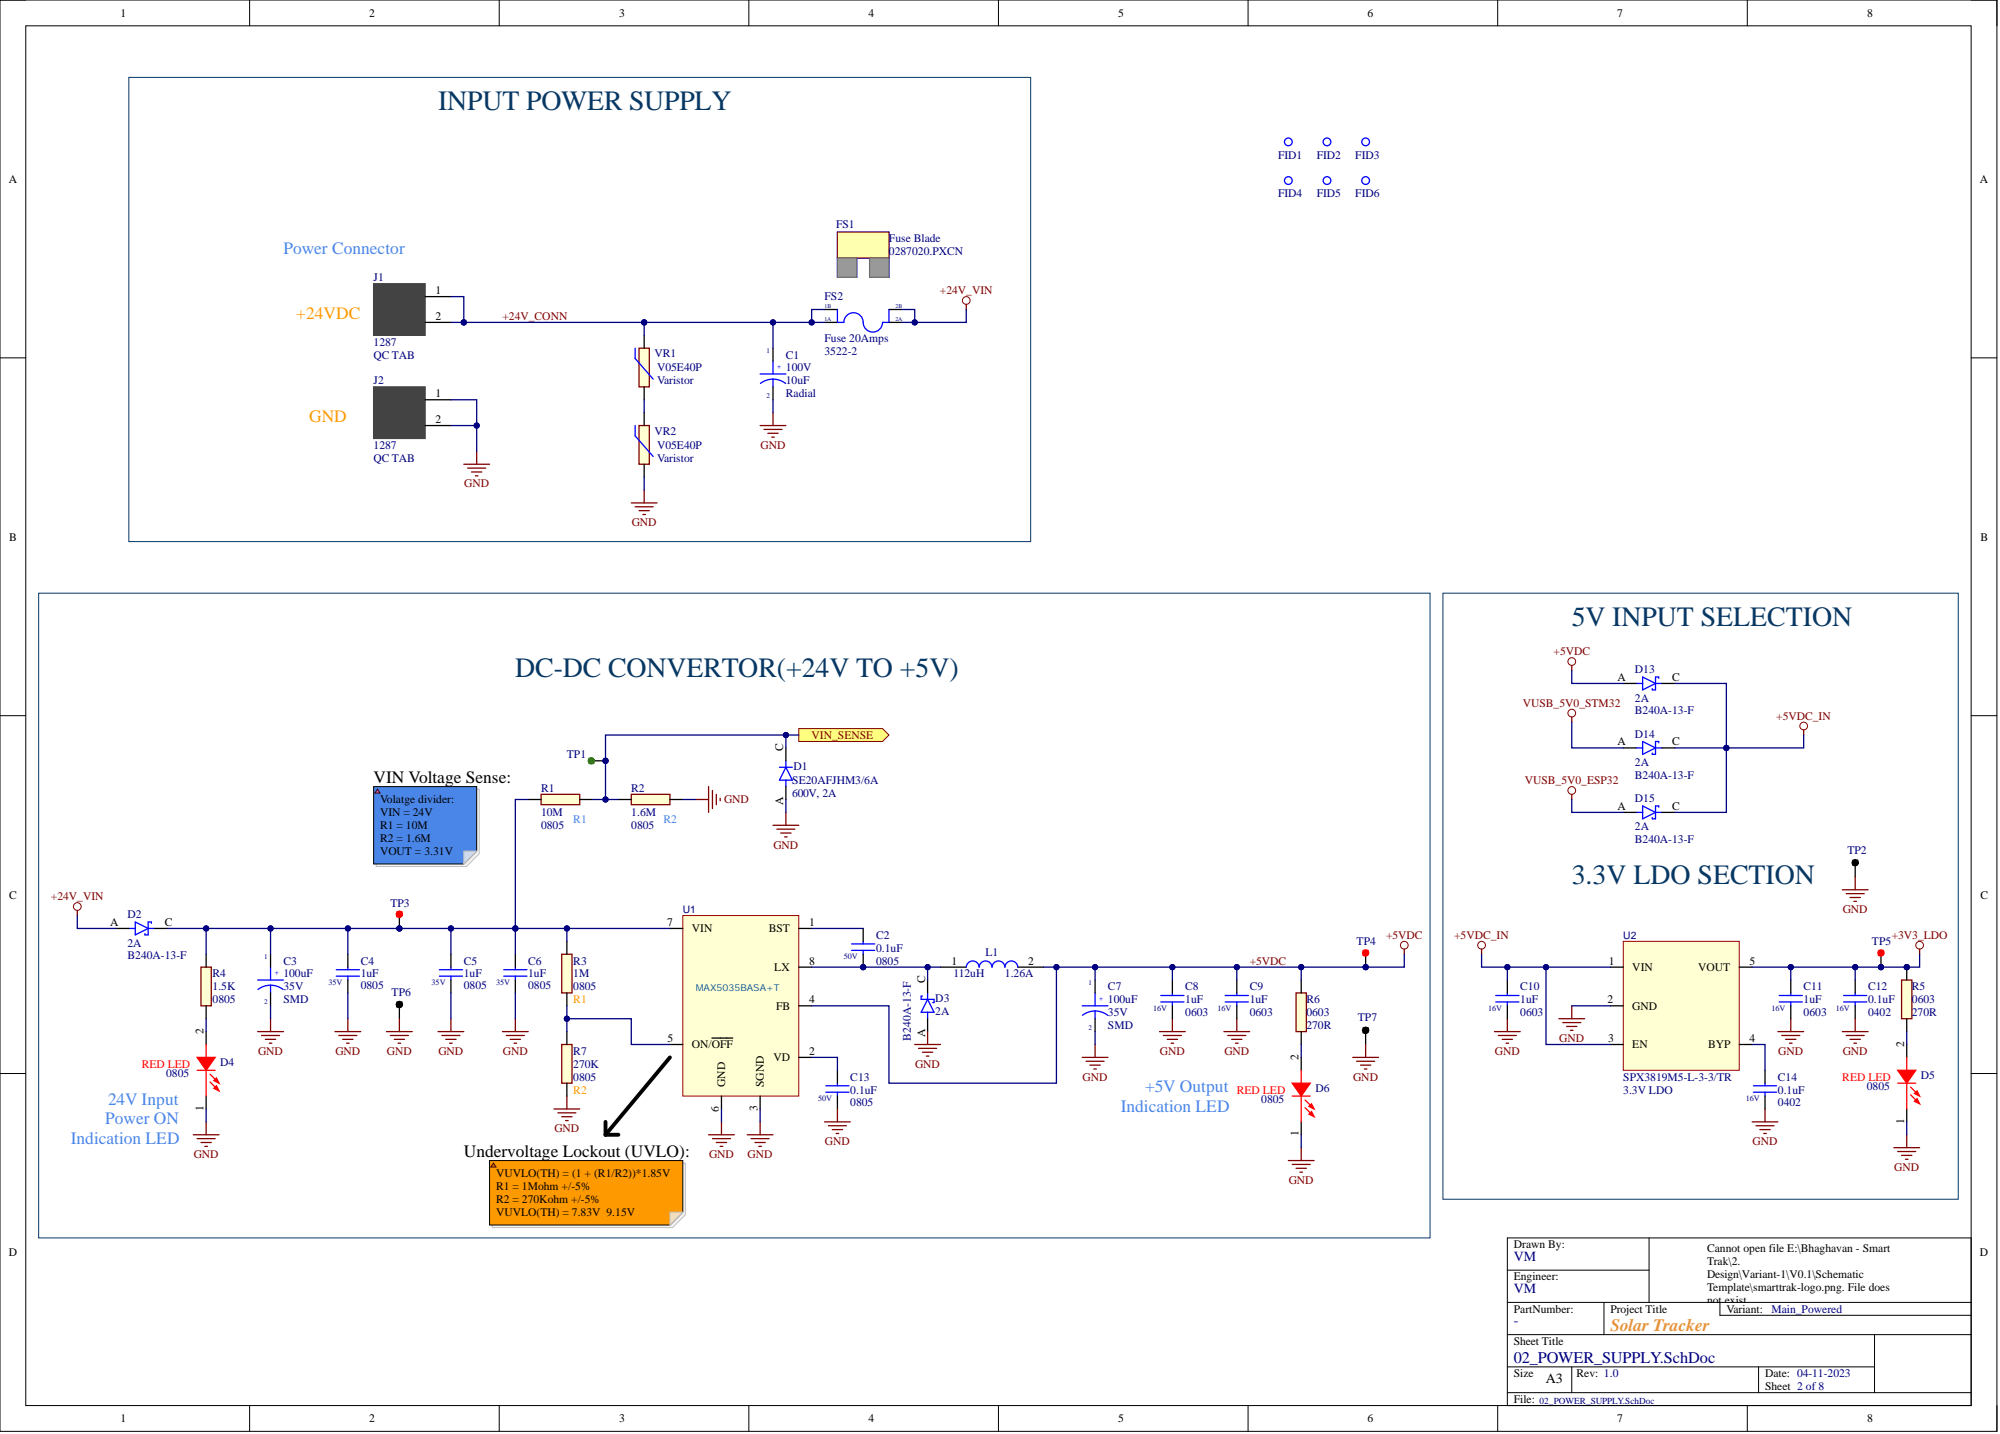
[picture p24: page 2]

DC-DC CONVERTOR(+24V TO +5V)

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

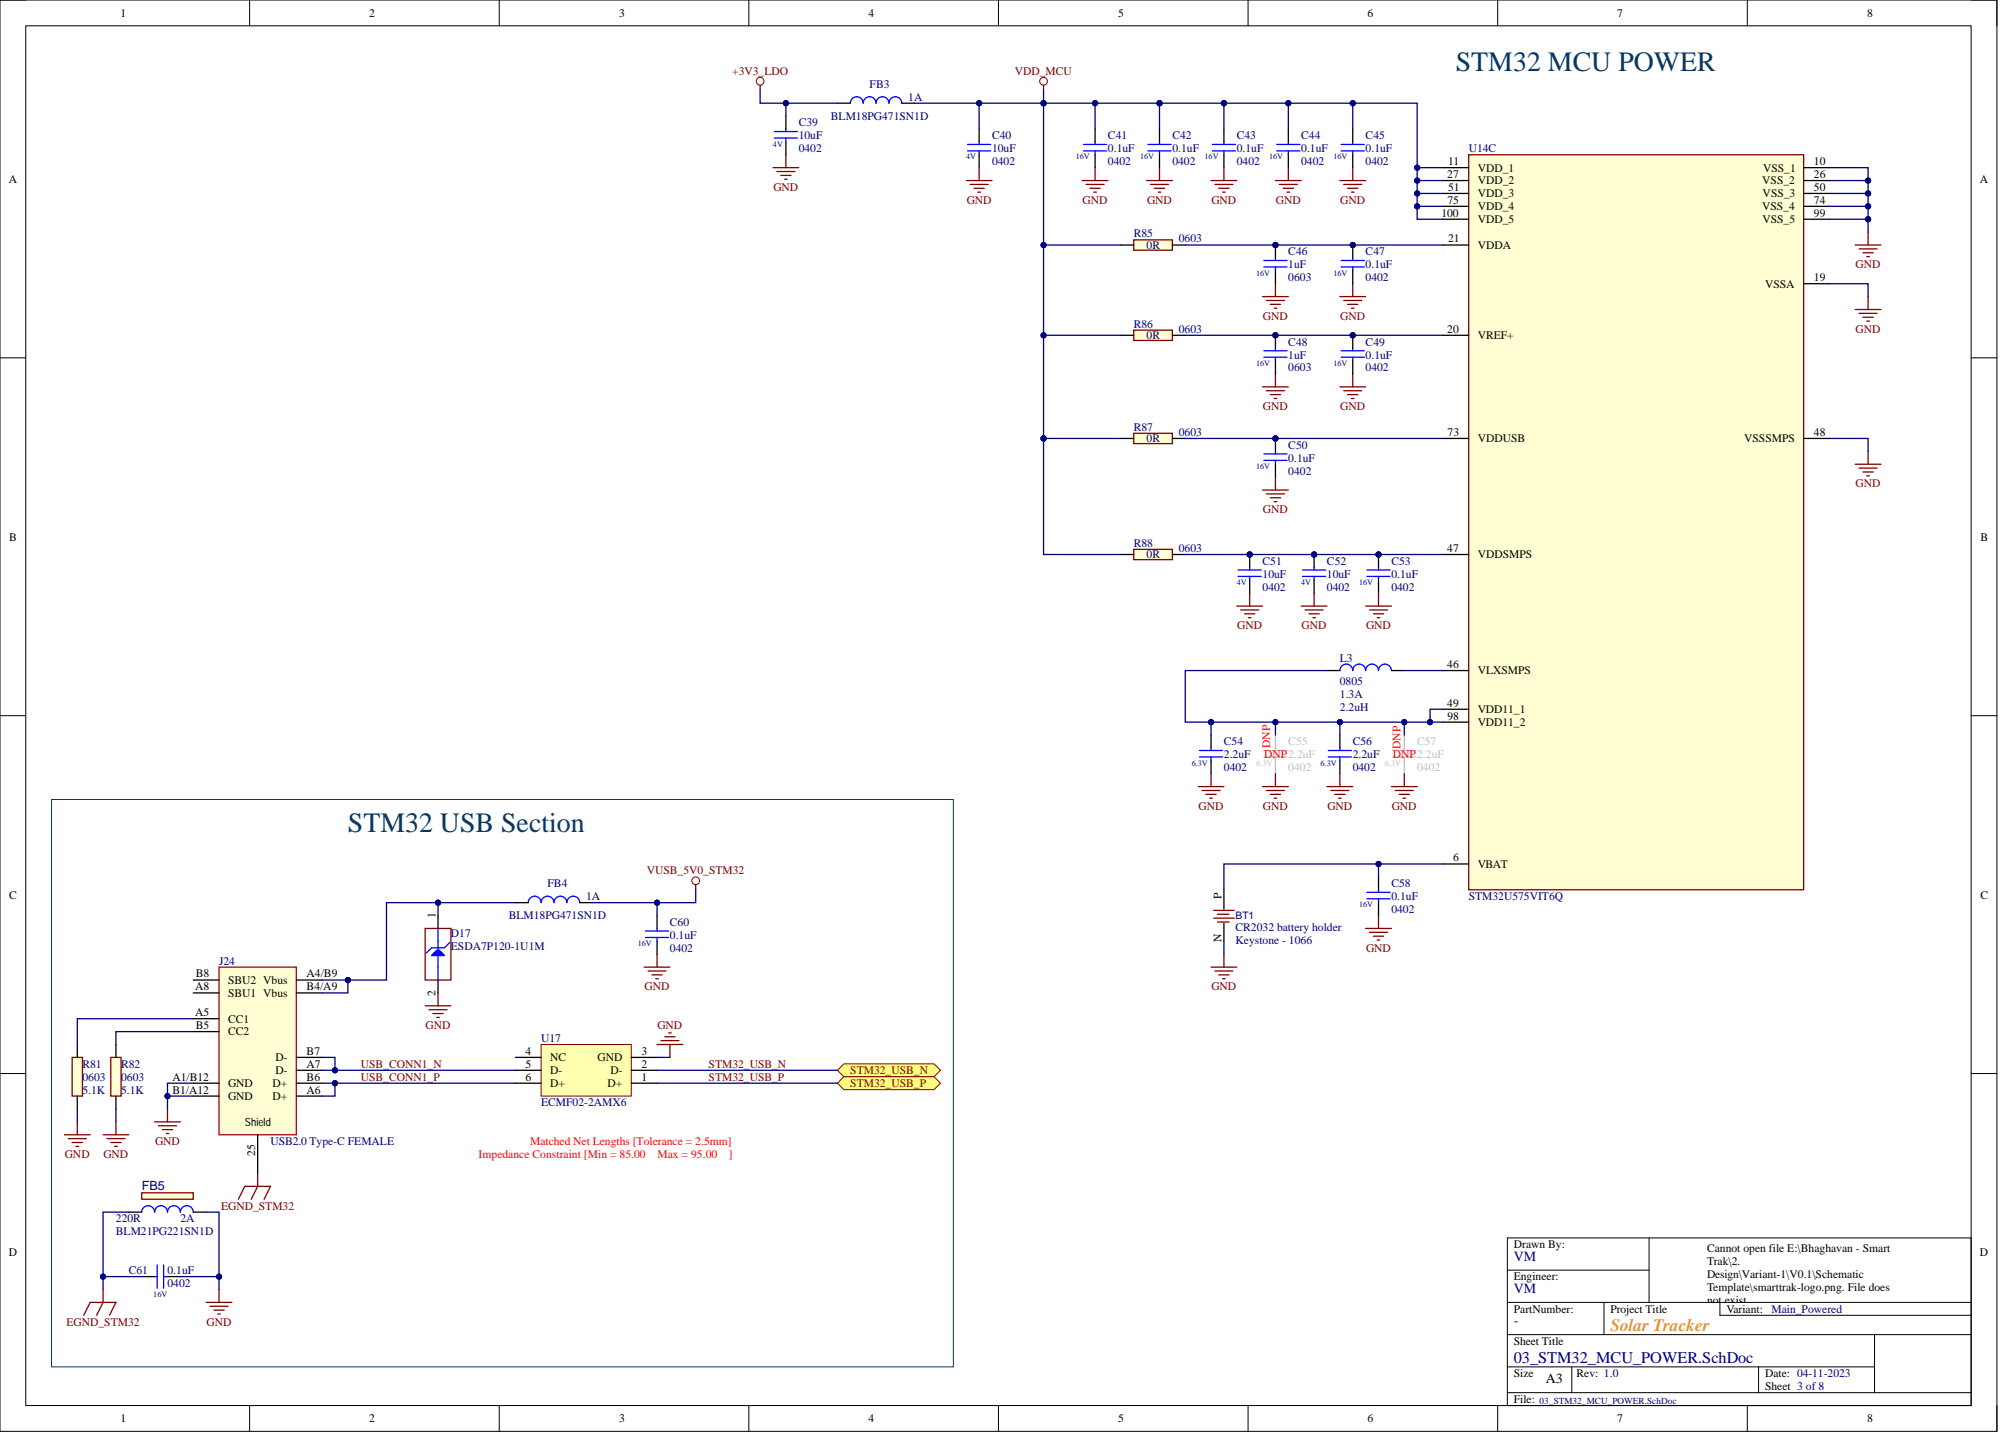
[picture p25: page 3]

1uF GND | 0.1uF | VREF+ 20

1uF GND | 0.1uF | VDDUSB 73

GND A1/B12

Matched Net Lengths [Tolerance = 2.5mm]

Impedance Constraint [Min = 85.00 Max = 95.00 ]

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

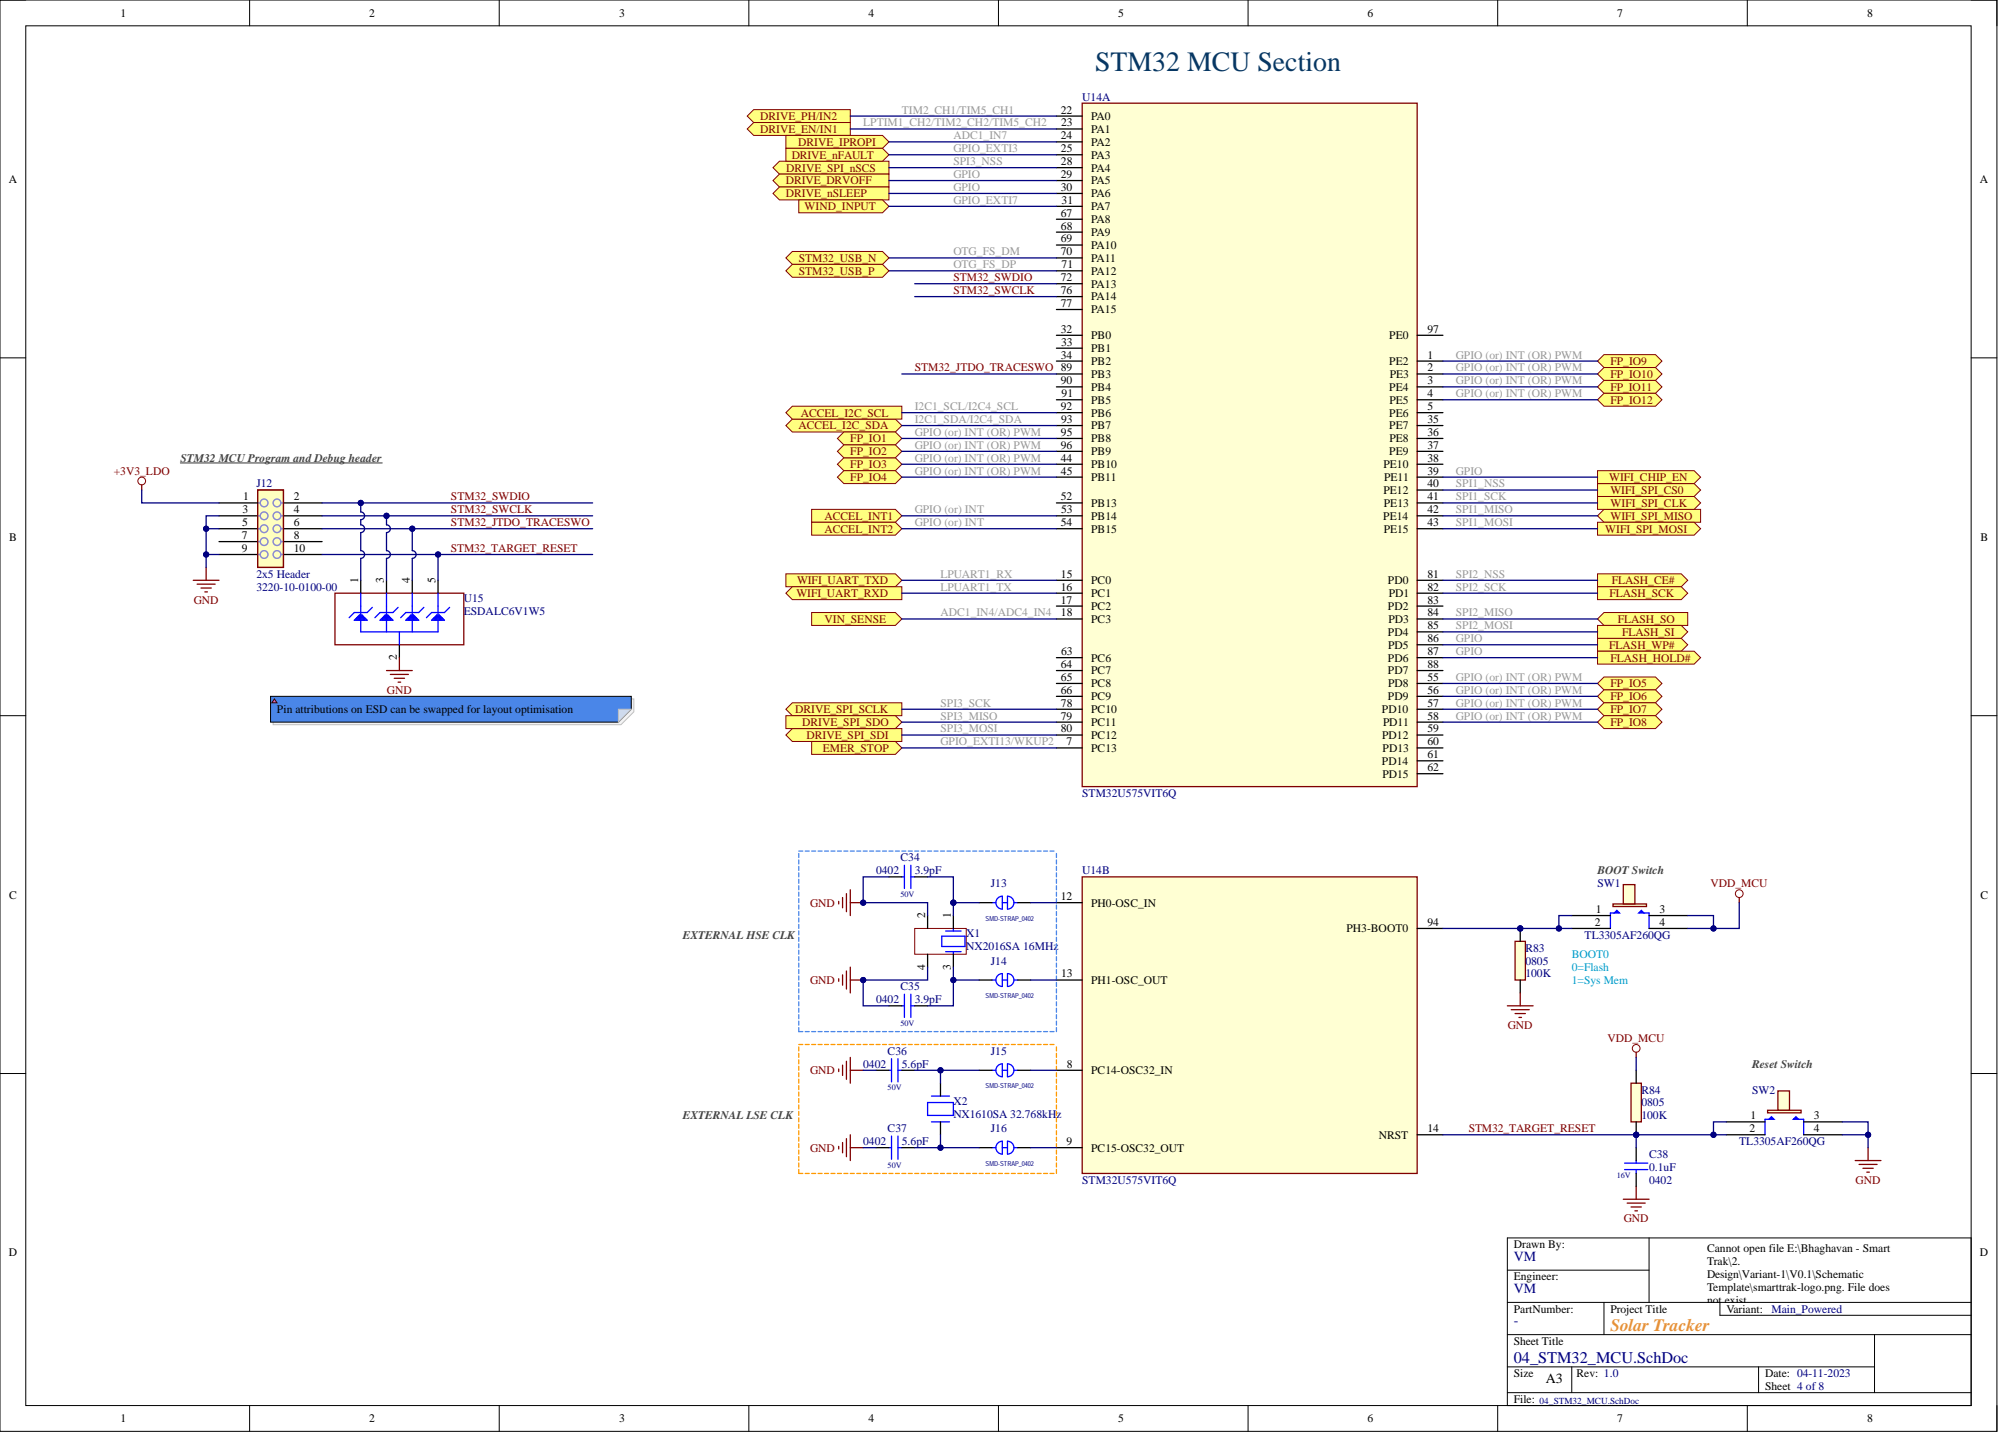
[picture p26: page 4]

GPIO (or) INT (OR) PWM

I2C1_SCL/I2C4_SCL
I2C1_SDA/I2C4_SDA

STM32 MCU Program and Debug header

Pin attributions on ESD can be swapped for layout optimisation

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

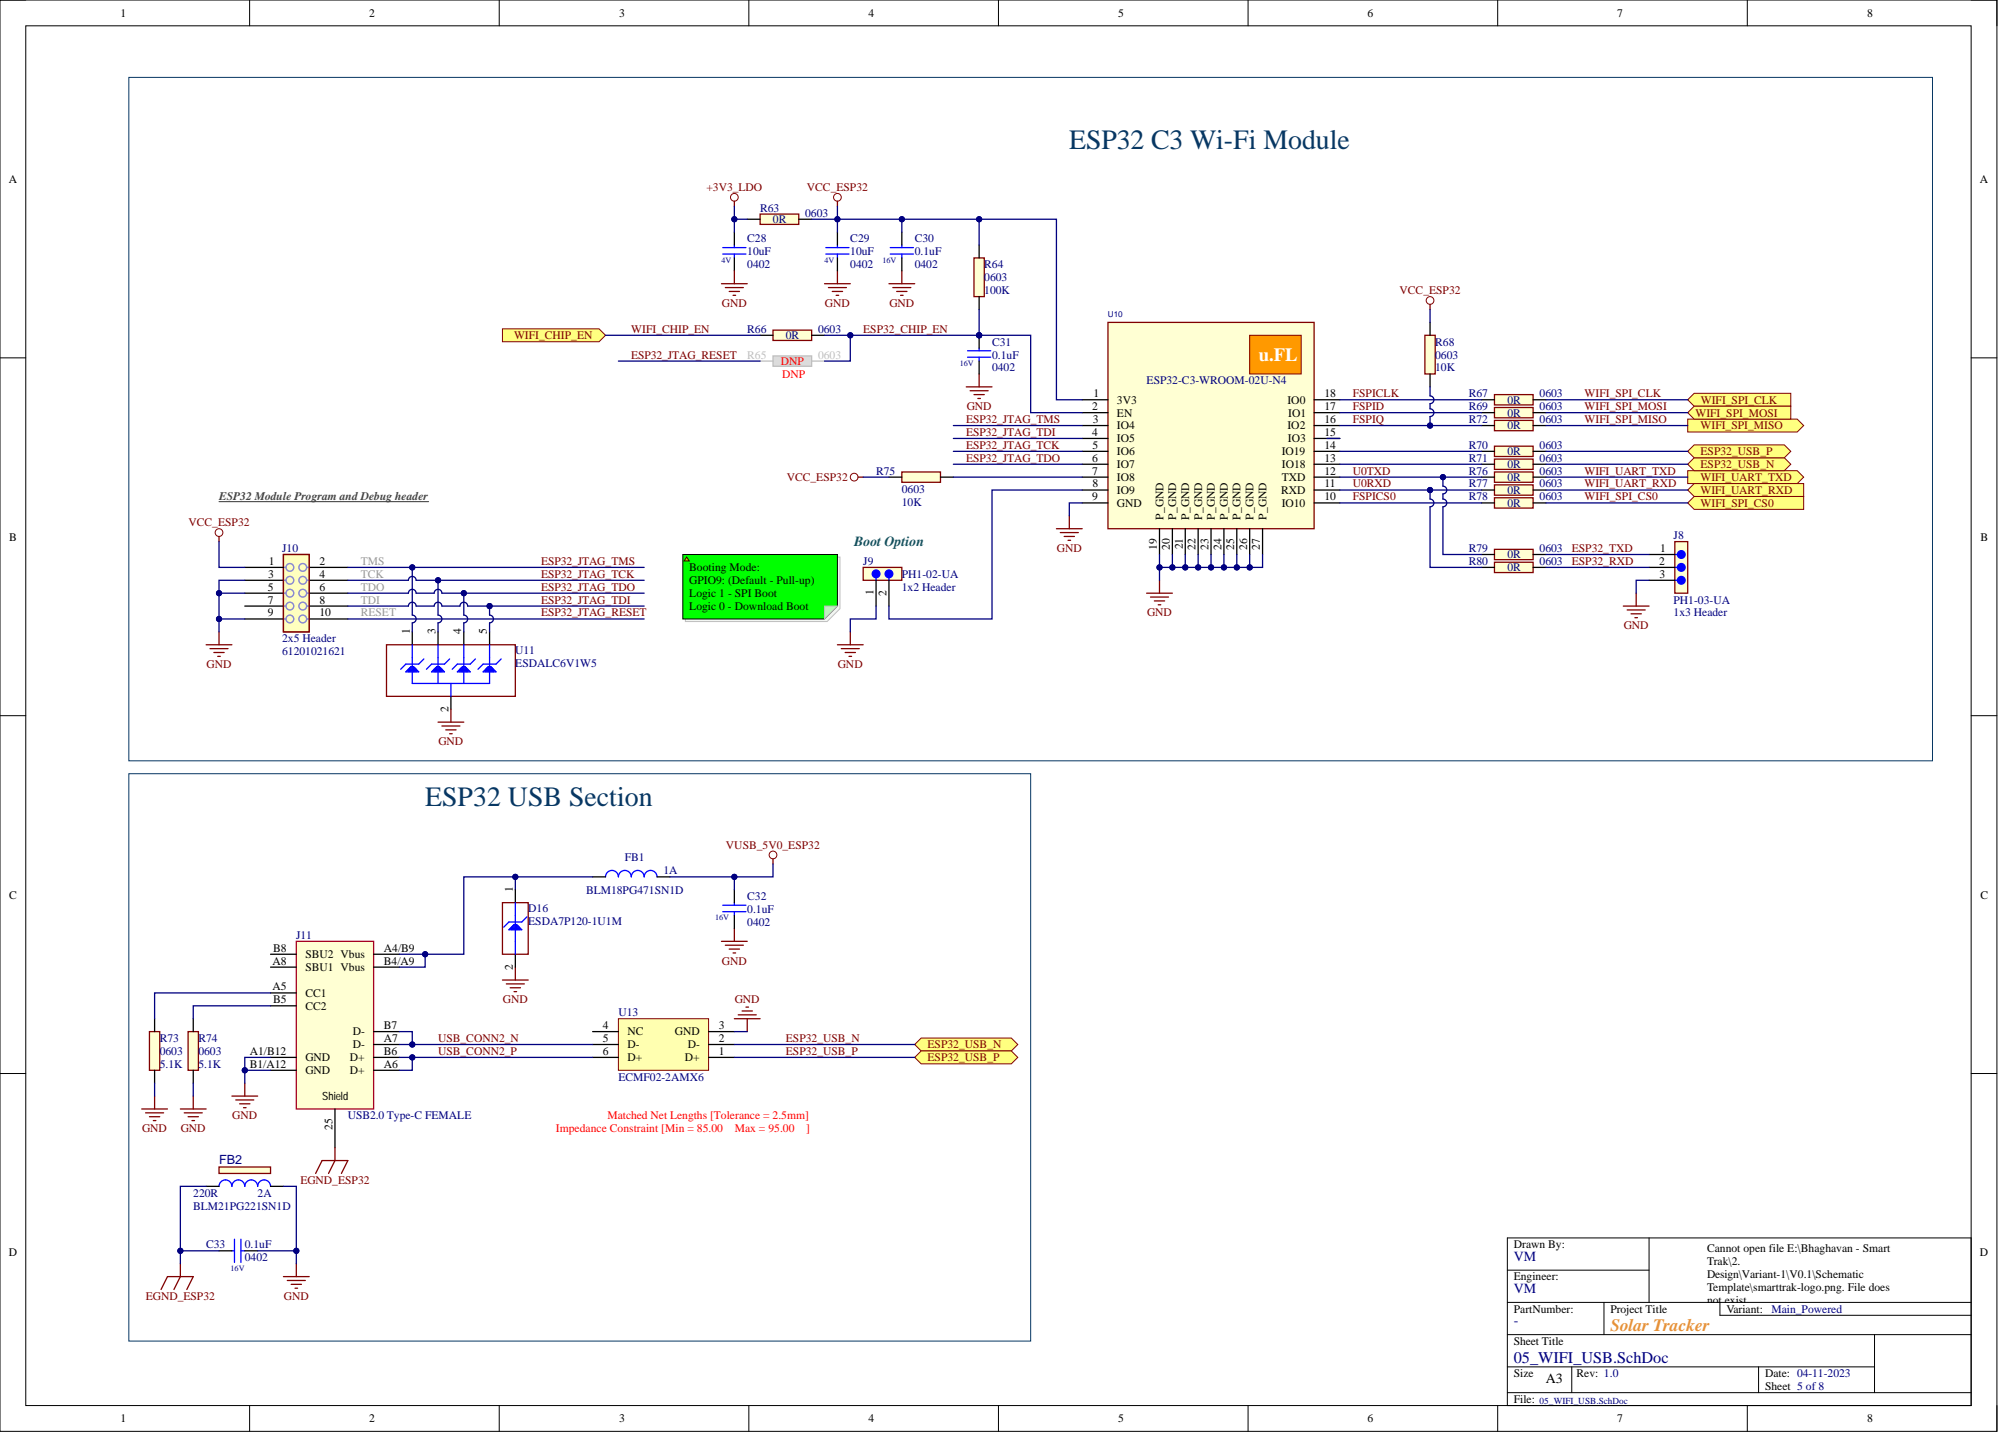
[picture p27: page 5]

ESP32-C3-WROOM-02U-N4 3V3 1

IO4 3 IO5 4 IO6 5 IO7 6 IO8 7 | WIFI_SPI_MISO

IO9 8 | U0RXD | | | WIFI_UART_RXD

ESP32 Module Program and Debug header

1x2 Header | | GND 9 | FSPICS0 | | WIFI_SPI_CS0

5 | 6 TDO
7 | 8 TDI

GND B1/A12

Matched Net Lengths [Tolerance = 2.5mm]

Impedance Constraint [Min = 85.00 Max = 95.00 ]

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

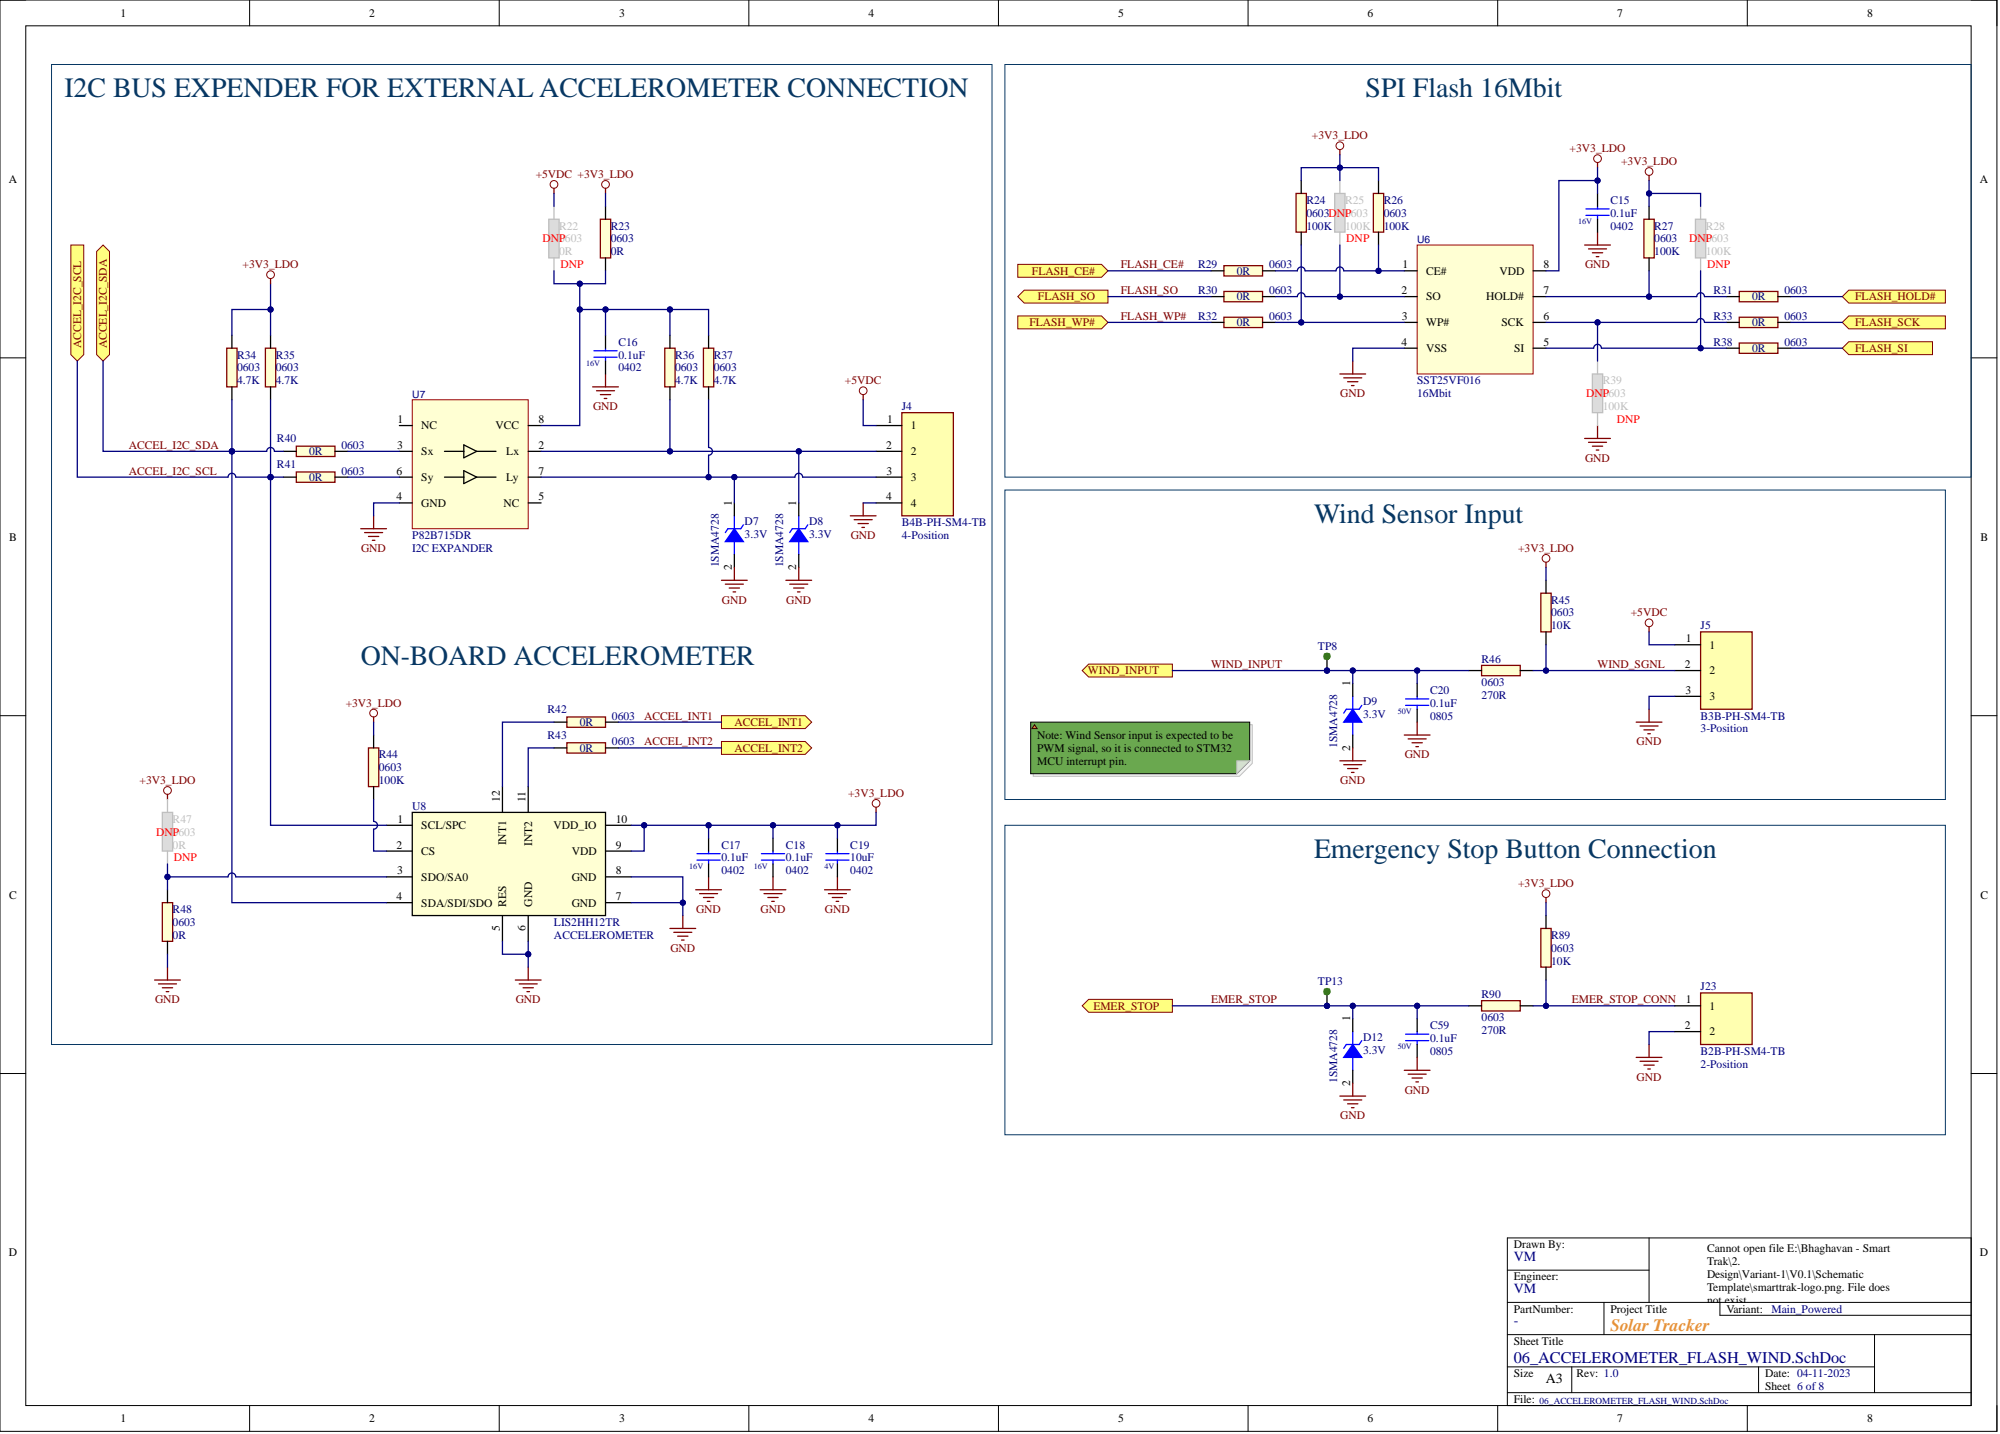
[picture p28: page 6]

I2C BUS EXPENDER FOR EXTERNAL ACCELEROMETER CONNECTION

Note: Wind Sensor input is expected to be
PWM signal, so it is connected to STM32
MCU interrupt pin.

Emergency Stop Button Connection GND

Cannot open file E:\Bhaghavan - Smart Trak\2.

Design\Variant-1\V0.1\Schematic Template\smarttrak-logo.png. File does

06_ACCELEROMETER_FLASH_WIND.Sch D o c
Size A

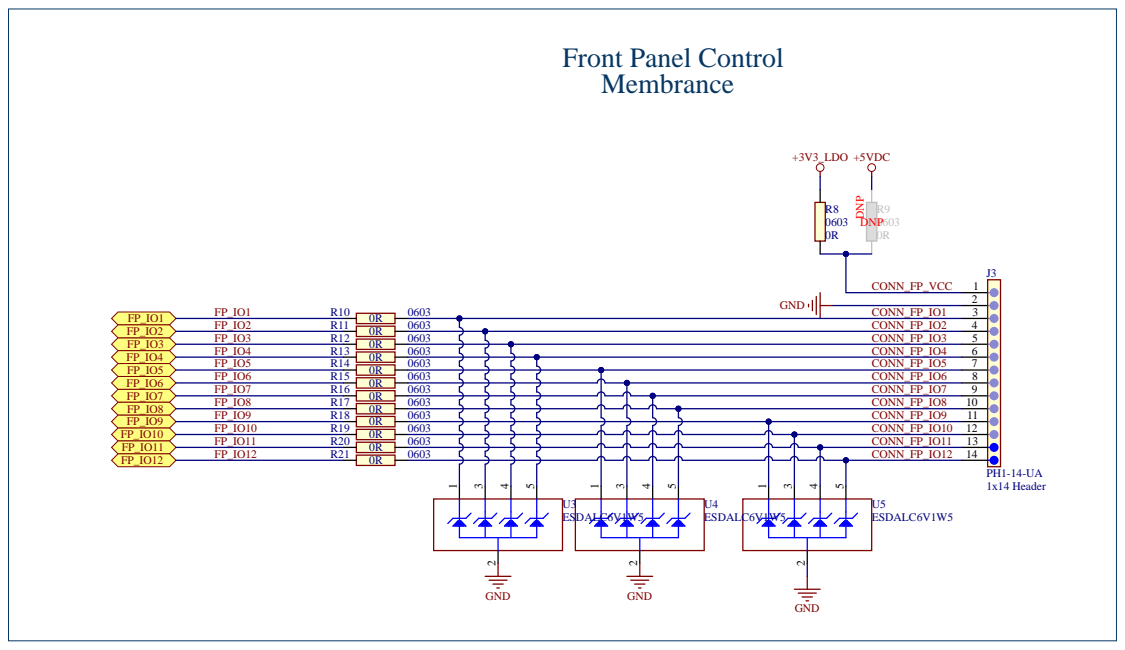
[picture p29: page 7]

CONN_FP_IO2
CONN_FP_IO3
CONN_FP_IO4
CONN_FP_IO5
CONN_FP_IO6
CONN_FP_IO7
CONN_FP_IO8
CONN_FP_IO9
CONN_FP_IO10 | 12
CONN_FP_IO1 1 | 13
CONN_FP_IO12 | 14

Cannot open file E:\Bhaghavan - Smart Trak\2.

Design\Variant-1\V0.1\Schematic Template\smarttrak-logo.png. File does

07_FRONT_PANEL_CONTROL.Sch D o c
Size A

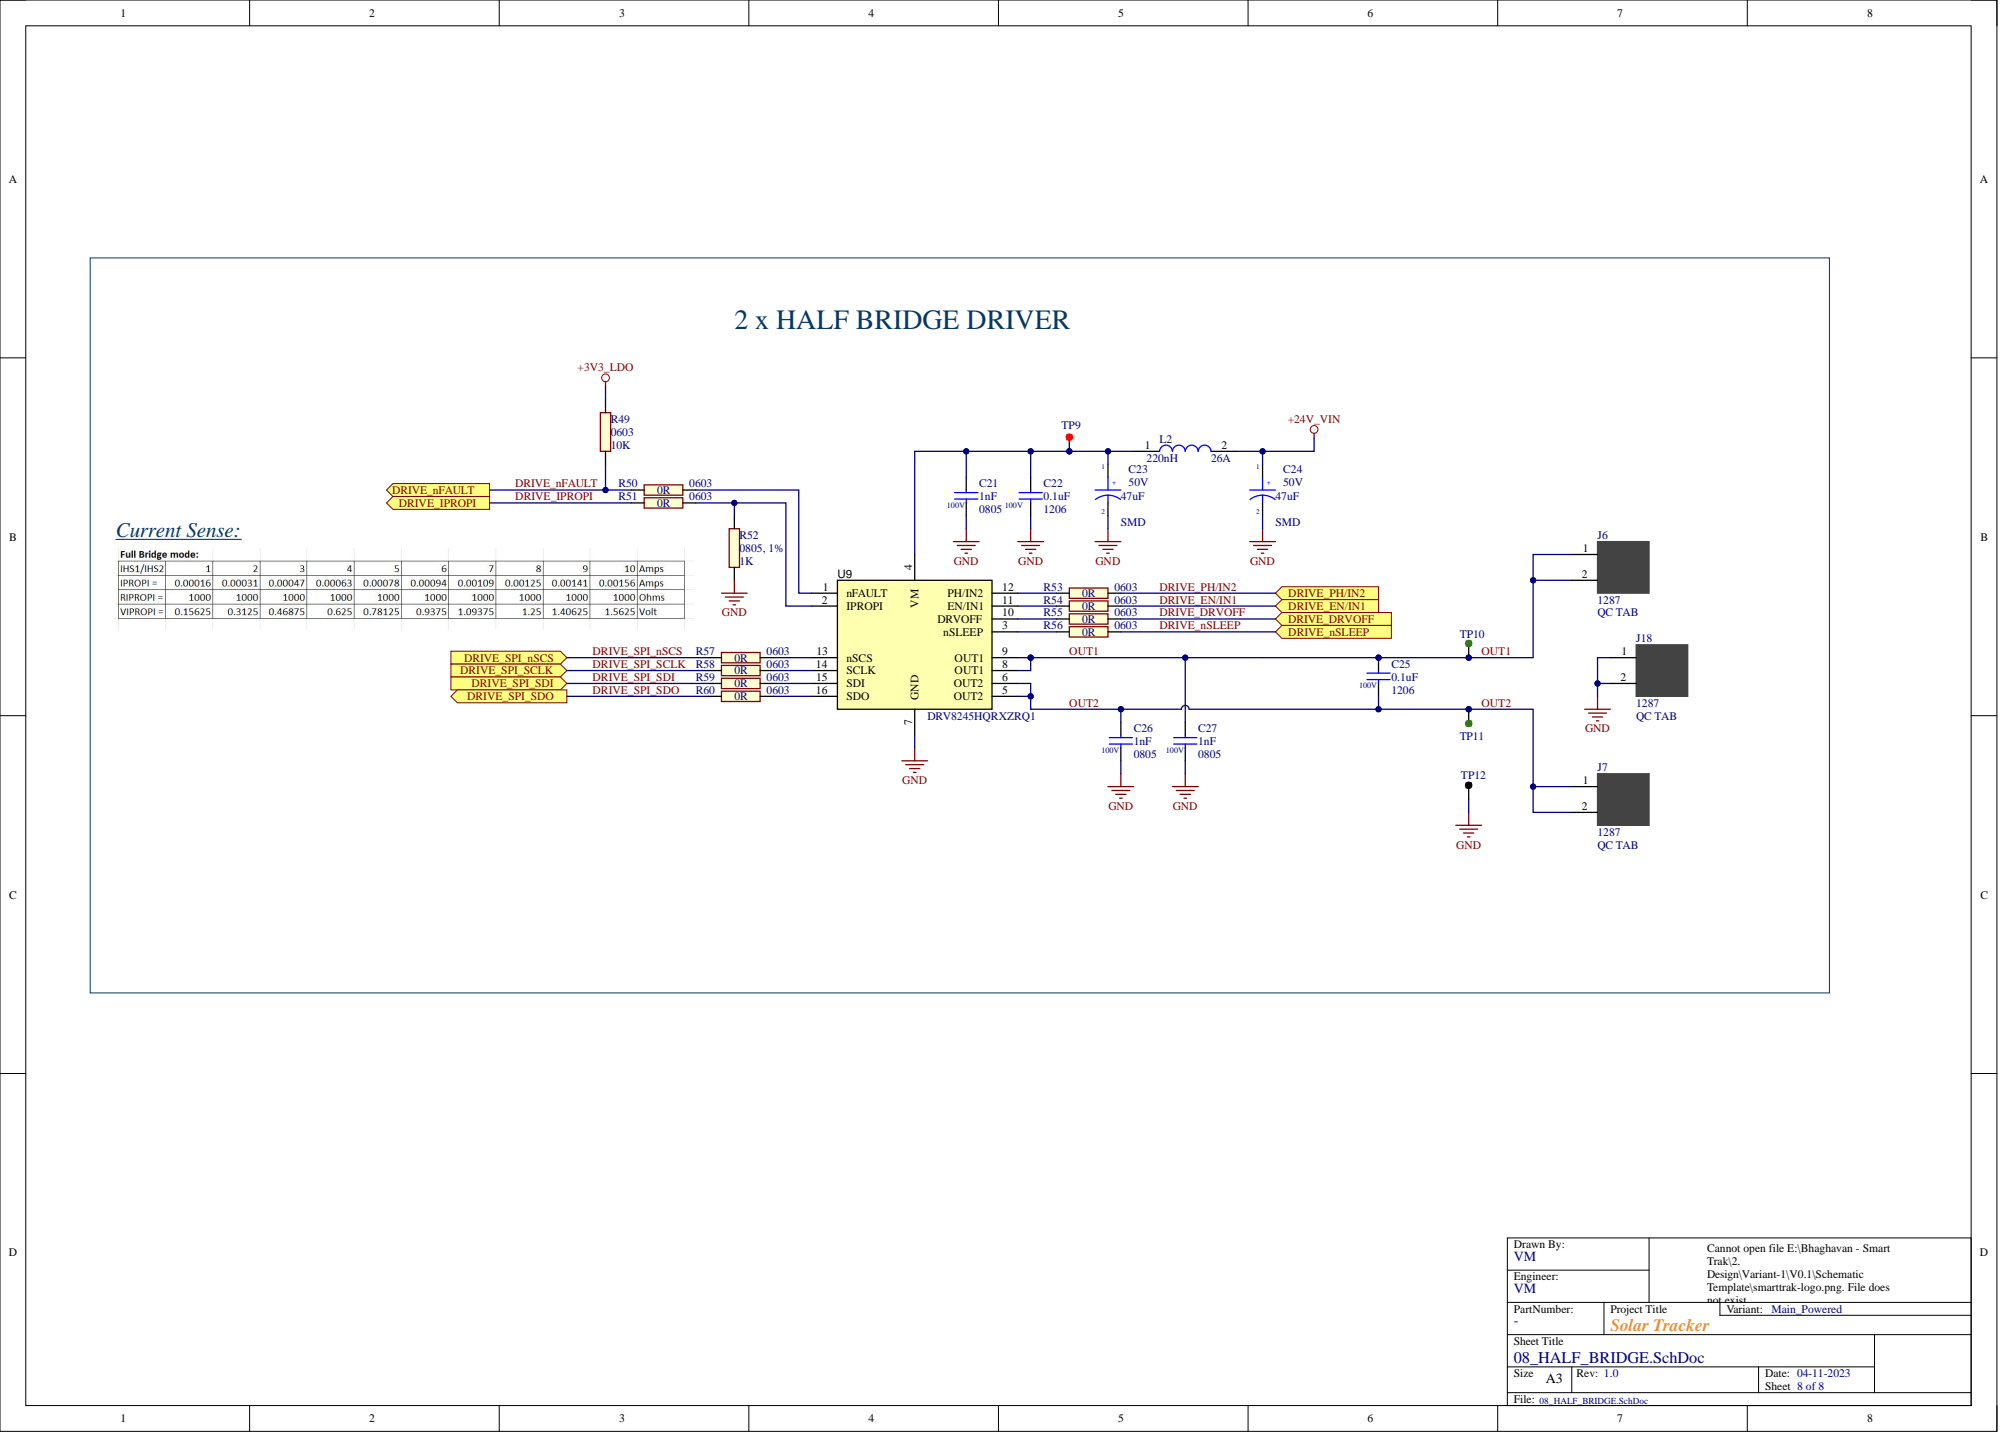
[picture p30: page 8]

Cannot open file E:\Bhaghavan - Smart Trak\2.

Design\Variant-1\V0.1\Schematic Template\smarttrak-logo.png. File does

08_HALF_BRIDGE.SchDo c
Size A
