konaiahgari-nithish-reddy/base_text/edge-firmware-BaseCode/Resources/STM32_USB_Section.pdf

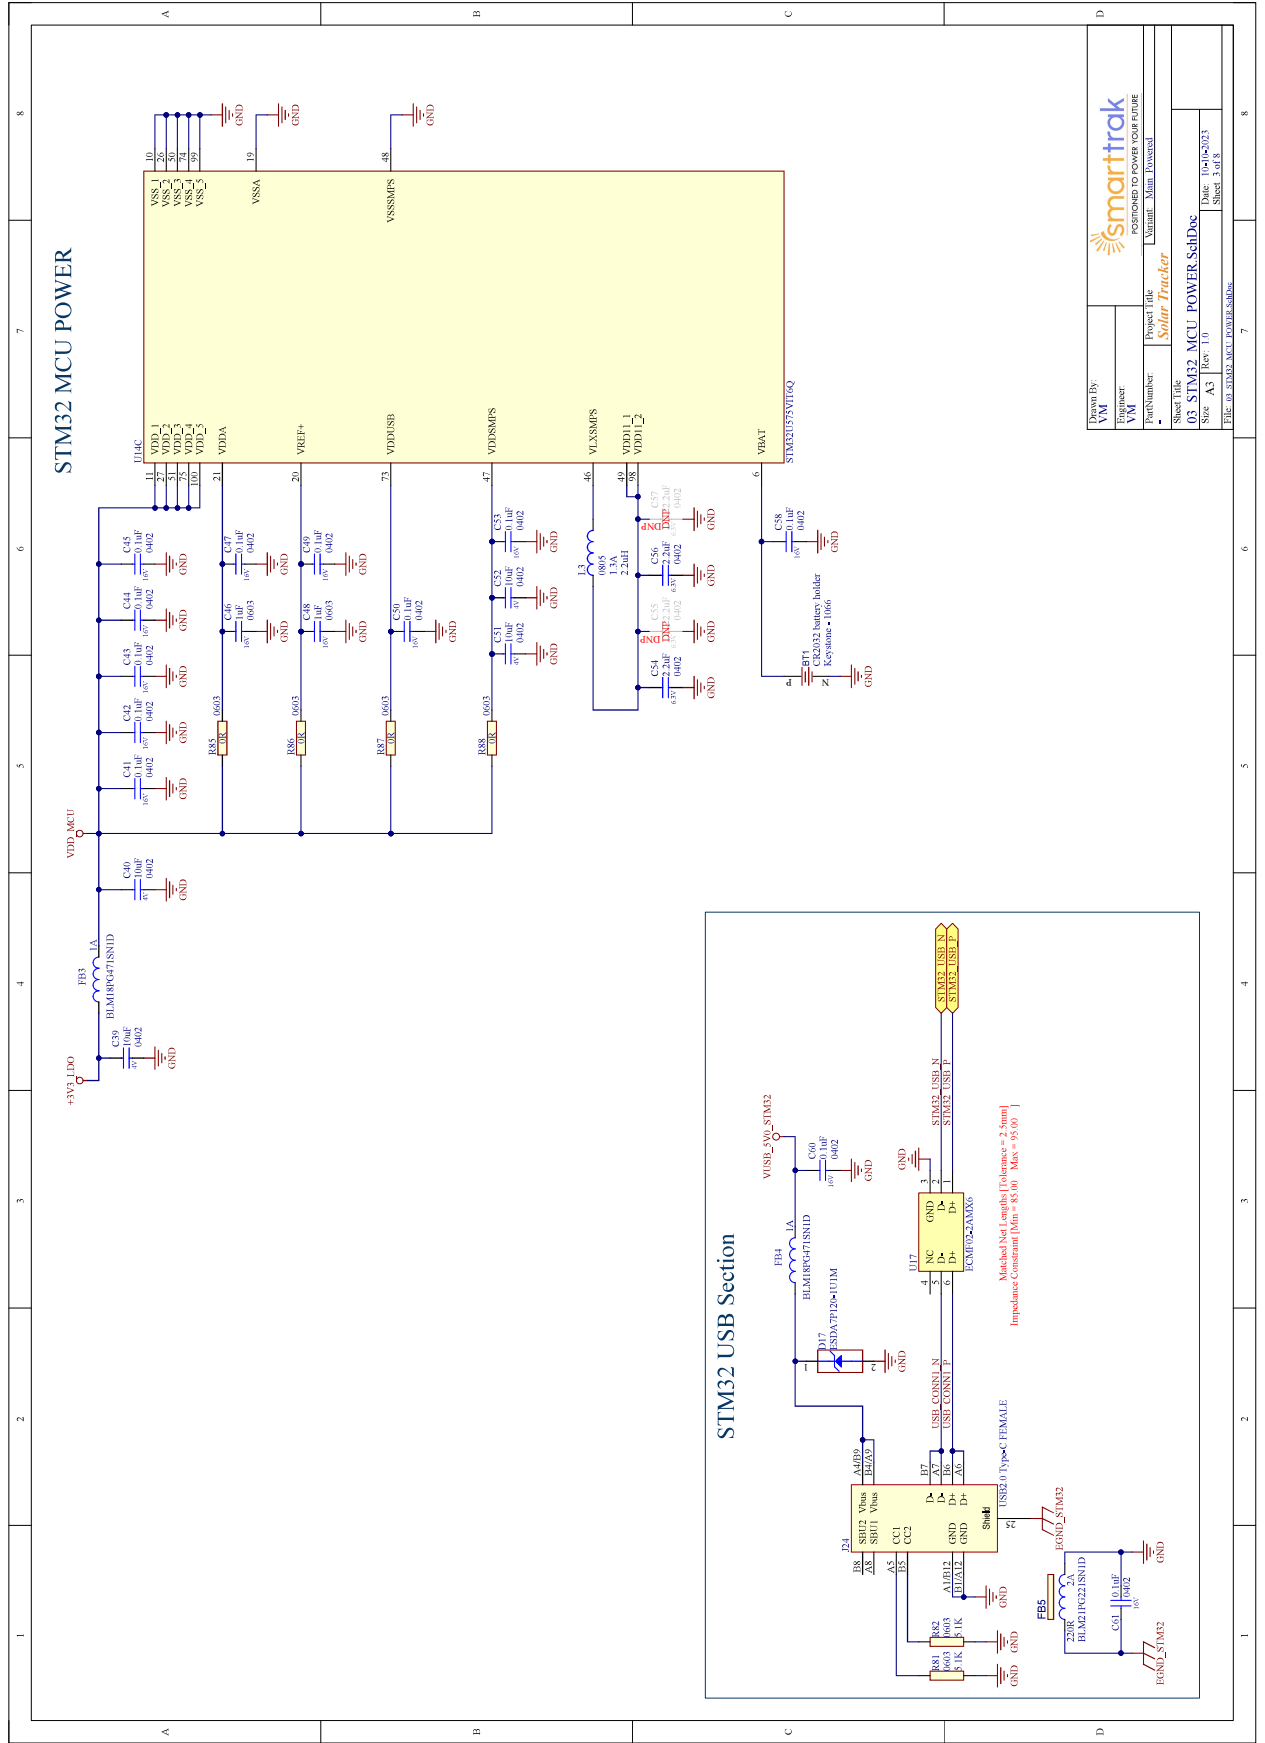
[picture p31: page 1]
DNP DNP

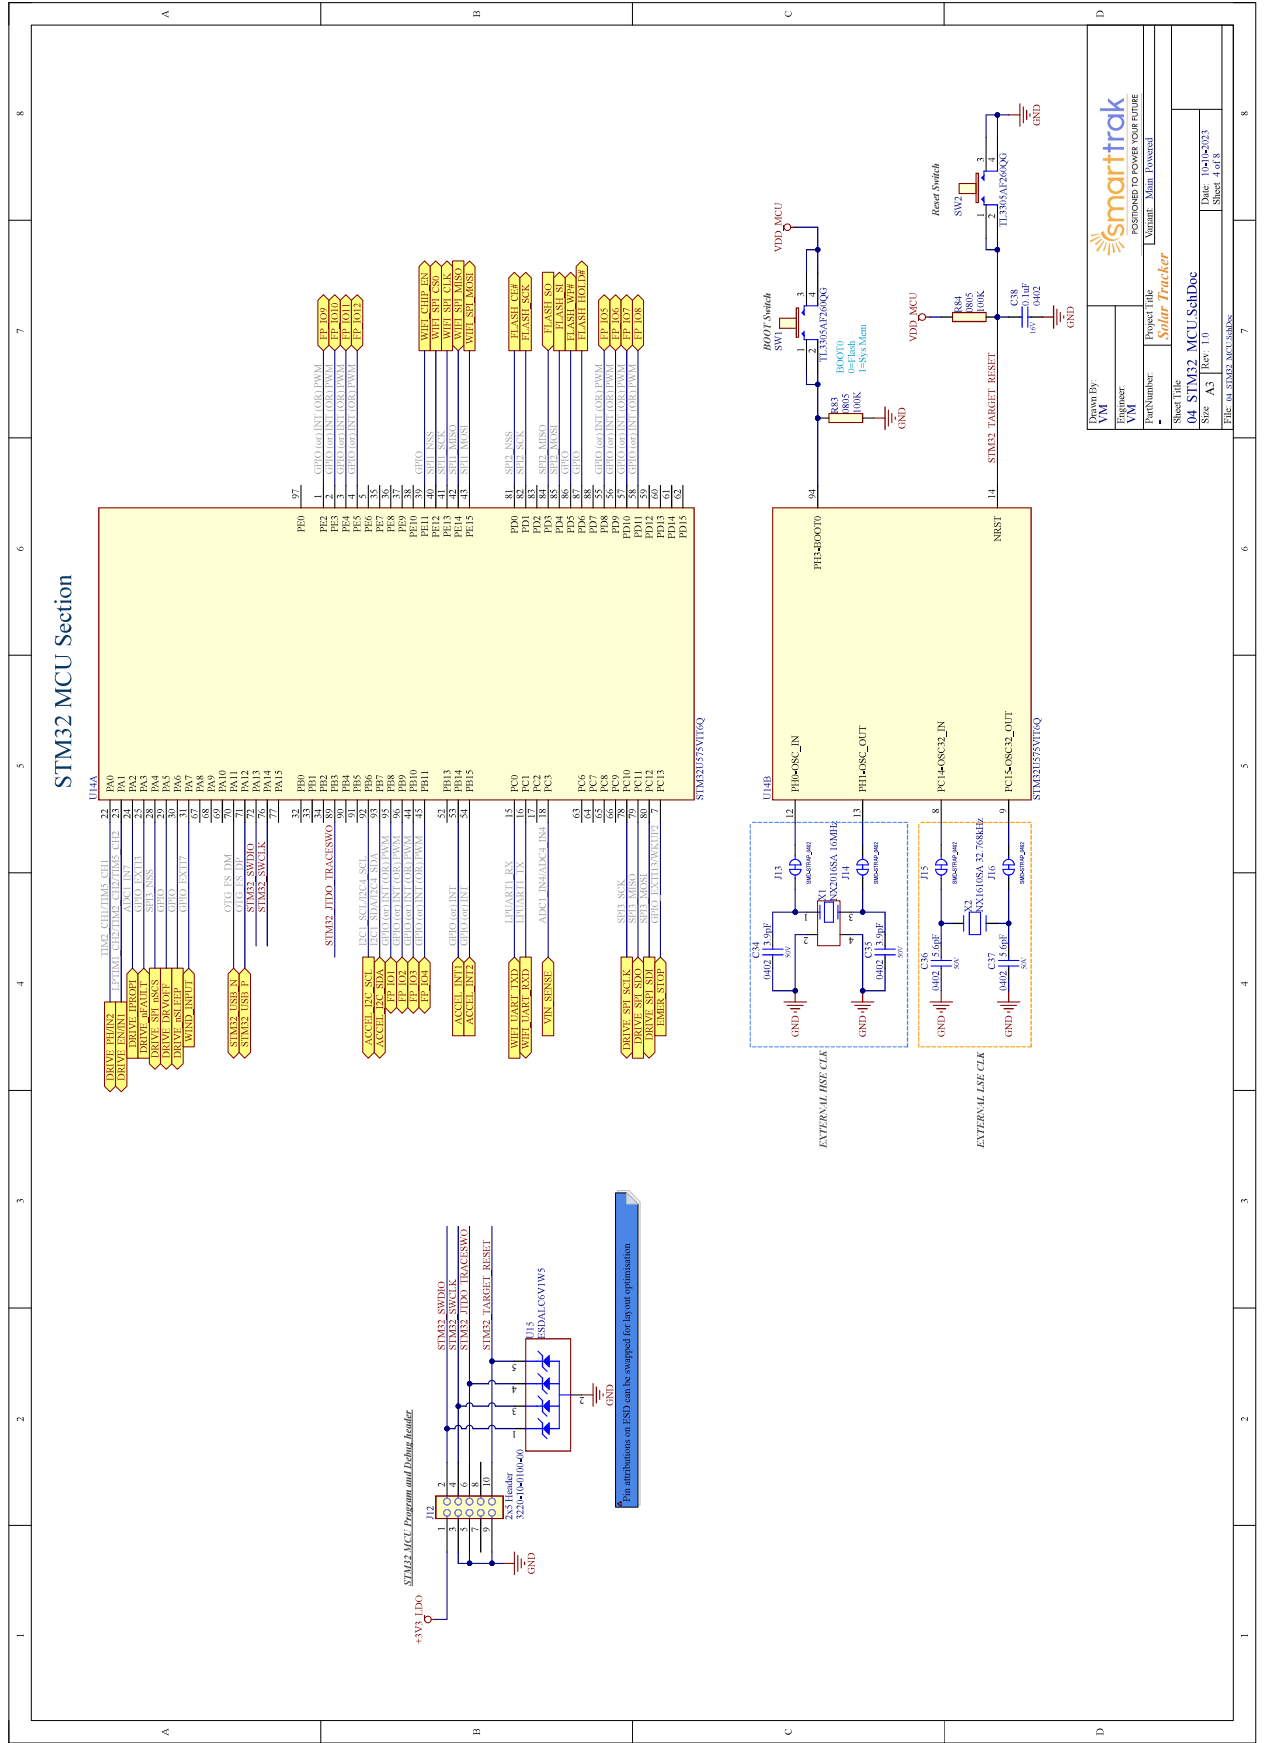
[picture p32: page 2]
