konaiahgari-nithish-reddy/base_text/edge-firmware-BaseCode/Stm32U5TrackerEnable/Core/Src/main.c

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
/* Includes ------------------------------------------------------------------*/
#include <string.h>
#include "main.h"
#include "PeripheralsInit.h"

/* USER CODE BEGIN Includes */
#include "usbd_cdc_if.h"
#include "usbd_conf.h"
#include "usbd_core.h"
#include "usbd_desc.h"
#include "usbd_cdc.h"

#include <GenericTypeDefs.h>
#include "config.h"
#define	DEFINE_GLOBALS
// NOTE: all header files that define global variables MUST be included here, even if the globals are not otherwise used in this file
#include "gsfstd.h"				// gsf standard #defines
#include "Debug.h"
#include "SmartTrak.h"			// Project wide definitions
#include "MenuFSM.h"
//#include "SST25VF016.h"		// SPI Flash function definitions
#include "MotionProfile.h"
#include "EventFlags.h"			// event flag definitions and globals
#include "Debounce.h"
#include "DS3232.h"				// Real Time Clock
#ifdef USE_MMA8452Q_INCLINOMETER
#include "mma845x.h"              // MMA845xQ definitions
#include "Inclinometer.h"
#endif
#include "SunPosition.h"		// Sun Position Calculations
#include "PanelPositionFSM.h"		// Sun Position FSM - operating modes
#include "MotionPhaseFSM.h"		// Motion Phase and Command Processing FSM functions, eMove type
#include "MotionSensor.h"		// Motion (Hall) Sensor functions
#include "MotorPWM.h"			// Motor PWM function prototypes and definitions
#include "MotionFSM.h"			// Motion Control function prototypes and definitions
#include "MotionLimits.h"		// Motion limits, based on physical limitations
#include "MotionStats.h"		// motion statistics for reporting
#include "MoveSequenceFSM.h"
#include "ButtonProcessingFSM.h" // Button and user input processing
#include "RxMessage.h"
#include "CoordTranslate.h"
#include "SerialDisplay.h"
#include "RTCC.h"
#include "Drv8245.h"
#include "LIS2HH12_Accelerometer.h"
#include "dwt_delay.h"
#include "ESP32FSM.h"
#undef	DEFINE_GLOBALS
#include "wifi_control.h"
/* USER CODE END Includes */

ADC_HandleTypeDef hadc1;

I2C_HandleTypeDef hi2c1;

UART_HandleTypeDef hlpuart1;
UART_HandleTypeDef huart3;

RTC_HandleTypeDef hrtc;

SPI_HandleTypeDef hspi1;
SPI_HandleTypeDef hspi2;

TIM_HandleTypeDef htim2;
TIM_HandleTypeDef htim4;
TIM_HandleTypeDef htim6;
TIM_HandleTypeDef htim7;

USBD_HandleTypeDef hUsbDeviceFS;
extern PCD_HandleTypeDef hpcd_USB_OTG_FS;

/* USER CODE BEGIN PV */
char ms5_cnt = 0,ms25_cnt=0,ms100_cnt=0;
BOOL ms5_fl=0,ms25_fl=0,ms100_fl=0;
volatile uint32_t timer_count = 0;
//volatile uint8_t timer_flag = 0;


//volatile uint8_t timer_flag = 0;
extern volatile uint32_t wifi_ctr;
extern volatile uint8_t wifi_flag;

extern volatile uint8_t rx_buff[RX_BUFF_SIZE];
extern volatile uint16_t rx_buff_ctr;
extern volatile uint8_t json_packet_flag;
extern volatile uint8_t json_validator;
extern volatile uint16_t json_packet_size;
extern uint8_t setting_flag;


uint32_t WwdgStatus = 0;
#ifdef INTERNAL_IMU
uint8_t imu_flag = 1;
#else
uint8_t imu_flag = 0;
#endif

WWDG_HandleTypeDef hwwdg;
static void WWDG_Init(void);
static uint32_t TimeoutCalculation(uint32_t timevalue);
IWDG_HandleTypeDef hiwdg;
static void MX_IWDG_Init(void);
/* USER CODE END PV */


/* USER CODE BEGIN PFP */

/* Definitions for defaultTask */

/* USER CODE END PFP */

/* USER CODE BEGIN 0 */
// These are the counting periods for the medium (25mS) and slow (100mS) events, based on a 5mS tick

#define _100MS_EVENT_PERIOD			(unsigned int)4			// 100ms period  @ 25mS
#define	_1S_EVENT_PERIOD			(unsigned int)40		// 1 Sec period @ 25mS

// this is based on the 100mS tick
#define	_15S_EVENT_PERIOD			(unsigned int)150		// 15 Sec period @ 100mS

enum tagMainErrors
{
	MAIN_ERROR_NONE = MAIN_ERROR_BASE,
	MAIN_ERROR_UNEXPECTED_TICK,				// 1 unexpected timer tick event
	MAIN_ERROR_UNEXPECTED_EVENT,			// 2 unexpected event
	MAIN_ERROR_INVALID_STATE,				// 3 not a valid state
	MAIN_ERROR_INVALID_SUBSTATE,			// 4 not a valid state
	MAIN_ERROR_UNKNOWN_COMMAND,				// 5 not a valid command
	MAIN_ERROR_25MS_TICK_OVERRUN,			// 6 unprocessed event flag
	MAIN_ERROR_100MS_TICK_OVERRUN,			// 7 unprocessed event flag
	MAIN_ERROR_1S_TICK_OVERRUN,				// 8 unprocessed event flag
	MAIN_ERROR_25MS_MOTION_TICK_OVERRUN,	// 9 unprocessed event flag

	MAIN_ERROR_UNPROCESSED_EVENT = MAIN_ERROR_BASE + 0x0F
};


// 5mS Tick Time distribution FSM States
enum tag5mSTickStates
{
	ST_5mS_TICK1,
	ST_5mS_TICK2,
	ST_5mS_TICK3,
	ST_5mS_TICK4,
	ST_5mS_TICK5
};

enum tag5mSTickStates e5mSTickState = ST_5mS_TICK1;

enum tag25mSTickStates
{
	ST_None,
	ST_25mS_TICK1,
	ST_25mS_TICK2,
	ST_25mS_TICK3,
	ST_25mS_TICK4,
	ST_25mS_TICK5
};

enum tag25mSTickStates e25mSTickState = ST_None;

enum tag100mSTickStates
{
	None,
	ST_100mS_TICK1,
	ST_100mS_TICK2,
	ST_100mS_TICK3,
	ST_100mS_TICK4
};

enum tag100mSTickStates e100mSTickState = None;

// This is a software counter used to time slower system events, such as button polling, etc.
unsigned int fg100mSTimerCount1 = _100MS_EVENT_PERIOD;
unsigned int fg100mSTimerCount2 = _100MS_EVENT_PERIOD;
unsigned int fg100mSTimerCount3 = _100MS_EVENT_PERIOD;
unsigned int fg100mSTimerCount4 = _100MS_EVENT_PERIOD;

BYTE fgbI2CErrorCtr = 0;	// Track I2C errors when reading Inclinometer
BYTE fgbI2CHrdStlCtr = 0;	// Track I2C errors when reading Inclinometer

PRIVATE_INIT float  fgdefferenceAngle = 0.0;
#define MIN_FLUCT_ANGLE     0.5
#define MIN_MANUAL_ANGLE     2

// these are just dummy structures passed to PanelPositionFSM() for initialization
static SmartTrakOrientation fgOrientation;

BOOL gIsMma845Enabled = TRUE;

void MenuFSM(void);
static void MX_USB_OTG_FS_PCD_Init(void);
//uint32_t DWT_Delay_Init(void);

uint8_t TxMessageBuffer[] = "Device ID: ";
#define VERSION		"2.17\r\n"

volatile uint32_t debug_ctr = 0;
FlagStatus debug_flag = RESET;
FlagStatus debug_cmd = RESET;
extern SmartTrakOrientation acquisitionAngle;
/* USER CODE END 0 */

/**
  * @brief  The application entry point.
  * @retval int
  */
int main(void)
{
  /* MCU Configuration--------------------------------------------------------*/

  /* Reset of all peripherals, Initializes the Flash interface and the Systick. */
  HAL_Init();

  /* USER CODE BEGIN Init */
	/* Reset the RTC peripheral and the RTC clock source selection */
//	HAL_PWR_EnableBkUpAccess();
//	__HAL_RCC_BACKUPRESET_FORCE();
//	__HAL_RCC_BACKUPRESET_RELEASE();

  /* Clear reset flags in any case */
    __HAL_RCC_CLEAR_RESET_FLAGS();
  /* USER CODE END Init */

  /* Configure the system clock */
  SystemClock_Config();

  /* Initialize all configured peripherals */
  MX_GPIO_Init();
  MX_ADC1_Init();
  MX_I2C1_Init();
  MX_LPUART1_UART_Init();
  MX_USART3_UART_Init();
  MX_MEMORYMAP_Init();
  MX_SPI1_Init();
  MX_SPI2_Init();
  MX_TIM2_Init();
//  MX_USB_OTG_FS_PCD_Init();
  MX_ICACHE_Init();
  MX_TIM4_Init();
  MX_RTC_Init();
#ifdef	WD_ENABLE
  MX_IWDG_Init();
#endif
  /* USER CODE BEGIN 2 */
  /* calculate delay to enter window. Add 1ms to secure round number to upper number  */
//    delay = TimeoutCalculation((hwwdg.Init.Counter-hwwdg.Init.Window) + 1) + 1;

  /* Init Device Library */
#ifdef	USB_LOG_ENABLE
    USBD_Init(&hUsbDeviceFS, &VCP_Desc, 0);

    /* Add Supported Class */
    USBD_RegisterClass(&hUsbDeviceFS, USBD_CDC_CLASS);

    /* Add CDC Interface Class */
    USBD_CDC_RegisterInterface(&hUsbDeviceFS, &USBD_CDC_fops);

    /* Start Device Process */
    USBD_Start(&hUsbDeviceFS);

    char UserTxBuffer[10] = {0};
    uint32_t uniqueid = *((uint32_t*)0x0BFA0700);
	snprintf(UserTxBuffer, 10, "ST%X", (unsigned int)uniqueid);

    if (hUsbDeviceFS.pClassData != NULL) {
        Transmit(TxMessageBuffer, sizeof(TxMessageBuffer));
        Transmit(UserTxBuffer, sizeof(UserTxBuffer));
	}

    HAL_Delay(1000);
    uart_send("Device ID: ");
    uart_send(UserTxBuffer);
	HAL_Delay(1000);
#endif
#ifdef	WD_ENABLE
    /* Refresh IWDG: reload counter */
     if(HAL_IWDG_Refresh(&hiwdg) != HAL_OK)
     {
       /* Refresh Error */
       Error_Handler();
     }
#endif

    // Resetting ESP32 Chip
    HAL_GPIO_WritePin(Wifi_Enable_GPIO_Port, Wifi_Enable_Pin, GPIO_PIN_RESET);
    HAL_Delay(100);
    HAL_GPIO_WritePin(Wifi_Enable_GPIO_Port, Wifi_Enable_Pin, GPIO_PIN_SET);
    HAL_Delay(3000);
//  BYTE bTemp;
//  	BOOL bRetVal = TRUE;


//  bRetVal = MMA845x_Standby();
//  	if (bRetVal IS FALSE)
//  		return bRetVal;

//  //	IIC_RegRead(SlaveAddressIIC, WHO_AM_I_REG);
//  	bRetVal = ReadInclinometerRegister(WHO_AM_I_REG, &bTemp);
//
//  	if ((bTemp IS MMA8452Q_ID) && (bRetVal IS TRUE))
//  		bRetVal = TRUE;
//  	else
//  		return (FALSE);

	InitializeParameretes();
  /* USER CODE END 2 */

//	 uint8_t  Buf[1000];
	/*while(1)
	{
		if (WIFI_Uart_Recv(Buf, sizeof(Buf)))
		{
			uart_send(Buf);//uart_send(Buf);
			HAL_Delay(100);
			WIFI_Uart_Send("Hello ESP32");
		}
		WIFI_Uart_Send("Hello ESP32");
		HAL_Delay(1000);
	}
	//  osKernelInitialize();  /* Call init function for freertos objects (in freertos.c) */
	//  MX_FREERTOS_Init();

	/* Start scheduler */
	//  osKernelStart();
	BITSET(efTimerEvents, EF_TIMER_5MS_TICK_INT);
	ms5_cnt=1;
	ms5_fl=1;

	char debug_buff[100];
	/* We should never get here as control is now taken by the scheduler */
	/* Infinite loop */
	/* USER CODE BEGIN WHILE */
	while (1)
	{
		/* USER CODE END WHILE */

		while(ms5_fl==1)
		{
#ifdef	WD_ENABLE
		    HAL_IWDG_Refresh(&hiwdg);
#endif
			uint8_t ch = 0;

			if (HAL_GPIO_ReadPin(GPIOH, GPIO_PIN_3) == GPIO_PIN_SET) {
				  HAL_GPIO_WritePin(Wifi_Enable_GPIO_Port, Wifi_Enable_Pin, GPIO_PIN_RESET);
				  HAL_Delay(1000);
				  HAL_GPIO_WritePin(Wifi_Enable_GPIO_Port, Wifi_Enable_Pin, GPIO_PIN_SET);
				  HAL_Delay(1000);
			}

			// Data Acquisition for Transmission
			if (wifi_flag == SET) {
				// Read Transmission Parameter
				read_monitor_params();
				create_mon_mqtt_packet();
				// Transmit via UART in blocking mode

				// Read packet reception ACK from ESP32
				wifi_ctr = 0;
				wifi_flag = RESET;
			}

			if(HAL_UART_Receive(&hlpuart1, &ch, 1, 1) == HAL_OK)
			{
				if (ch == '{') {
					json_validator++;
					if (json_validator<2) {
						memset(rx_buff, 0, RX_BUFF_SIZE);
					}
				}
				if (ch == '}') {
					json_validator--;
					rx_buff[rx_buff_ctr++] = ch;
					if (json_validator == 0) {
						json_packet_flag = 1;
					}
				}
				if (json_validator > 0) {
					rx_buff[rx_buff_ctr++] = ch;
				}

			}
			if (json_packet_flag == 1) {
				json_packet_flag = 0;
				json_packet_size = 0;
				rx_buff_ctr = 0;
				json_validator = 0;
				parse_stm32_packet(rx_buff, strlen(rx_buff));
				memset(rx_buff, 0, RX_BUFF_SIZE);
			}

			if (setting_flag != 0) {
				read_setting_params();
				create_read_setting_mqtt();
				setting_flag = 0;
			}

			if (debug_flag == SET && debug_cmd == SET) {
				debug_flag = RESET;
				memset(debug_buff, 0, sizeof(debug_buff));
				snprintf(debug_buff, 85, "Sun_EL: %f\tSun_Az: %f\tTarget: %f \tTracker: %f \n",ptrRTCC_RAM_AppParameters->fSPACalculation_EL, ptrRTCC_RAM_AppParameters->fSPACalculation_AZ, acquisitionAngle.fModuleTiltAngleDegrees, pgAngleAverage.fX_Angle);
				Transmit(debug_buff, sizeof(debug_buff));
			}
			if (imu_flag == 1) {
				MainMenu('i');
				imu_flag = 0;
			}
#ifdef USE_AZIMUTH

			if (IS_BITSET(efMotionSensorEvents[MOTOR_AZIMUTH], EF_MOTION_SENSOR_TICK))
			{
				MotionSensor_Tick(MOTOR_AZIMUTH);			// processes current speed for PWM adjustments

				//continue;				// we have processed something, so restart at the top of the loop
			}
#endif
#ifdef USE_ELEVATION
			if (IS_BITSET(efMotionSensorEvents[MOTOR_ELEVATION], EF_MOTION_SENSOR_TICK))
			{
				MotionSensor_Tick(MOTOR_ELEVATION);			// processes current speed for PWM adjustments

				//continue;				// we have processed something, so restart at the top of the loop
			}
#endif

			if (IS_BITSET(efTimerEvents, EF_TIMER_5MS_TICK_INT))
			{
				//									// clear event flag (5mS event overrun is handled in the 5mS timer interrupt)
				BITCLEAR(efTimerEvents, EF_TIMER_5MS_TICK_INT);

				//-------------------------------
				//	Switch Debounce on all 5mS Ticks
				//-------------------------------
				// handle 5mS events


#ifdef USE_PCA9554_IO					// enabled in config.h ONLY if PCA9554 for Switch Input is present
#ifdef USE_DEBOUNCE_TRIGGER
				Trigger1Level(1);				// trigger to allow viewing this event on a scope
#endif

				Input_Debounce_FSM(FALSE);			// input switch debounce handling, called unconditionally every 5mS

#ifdef USE_DEBOUNCE_TRIGGER
				Trigger1Level(0);				// trigger to allow viewing this event on a scope
#endif
#endif
				switch (e5mSTickState)
				{
				//-------------------------------
				//			5mS Tick 1
				//-------------------------------
				case ST_5mS_TICK1:
					// check for 25mS event overrun
					if (IS_BITSET(efSchedulerEvents, EF_SCHED_25MS_TICK1))
					{
						//					RuntimeError(MAIN_ERROR_25MS_TICK_OVERRUN);
					}
//															uart_send("\r\n5ms tick 1\r\n");
					BITSET(efSchedulerEvents, EF_SCHED_25MS_TICK1);
					e25mSTickState = ST_25mS_TICK1;
					e5mSTickState = ST_5mS_TICK2;			// bump state for next tick
					break;

					//-------------------------------
					//			5mS Tick 2
					//-------------------------------
				case ST_5mS_TICK2:
					// check for 25mS event overrun
					if (IS_BITSET(efSchedulerEvents, EF_SCHED_25MS_TICK2))
					{
						//					RuntimeError(MAIN_ERROR_25MS_TICK_OVERRUN);
					}
					//											uart_send("\r\n5ms tick 2\r\n");
					BITSET(efSchedulerEvents, EF_SCHED_25MS_TICK2);
					e25mSTickState = ST_25mS_TICK2;
					e5mSTickState = ST_5mS_TICK3;			// bump state for next tick
					break;

					//-------------------------------
					//			5mS Tick 3
					//-------------------------------
				case ST_5mS_TICK3:
					// check for 25mS event overrun
					if (IS_BITSET(efSchedulerEvents, EF_SCHED_25MS_TICK3))
					{
						//					RuntimeError(MAIN_ERROR_25MS_TICK_OVERRUN);
					}
					//										uart_send("\r\n5ms tick 3\r\n");
					BITSET(efSchedulerEvents, EF_SCHED_25MS_TICK3);
					e25mSTickState = ST_25mS_TICK3;
					e5mSTickState = ST_5mS_TICK4;			// bump state for next tick
					break;

					//-------------------------------
					//			5mS Tick 4
					//-------------------------------
				case ST_5mS_TICK4:
					//-------------------------------
					//	25mS Azimuth Motion Timer
					//-------------------------------
					// ==> this delay may be anything UP TO 25mS; the start of the delay is asynchronous in MotionFSM(), but the end is always on Tick4
					if (IS_BITSET(efMotionTimerEvents[MOTOR_AZIMUTH], EF_MTN_TIMER))
					{
						// Azimuth motion timer is enabled
						// check for 25mS Motion Timer event overrun
						if (IS_BITSET(efMotionTimerEvents[MOTOR_AZIMUTH], EF_MTN_TIMER_25MS_TICK))
						{
							//						RuntimeError(MAIN_ERROR_25MS_MOTION_TICK_OVERRUN);
						}

						// set event flag; processed by MotionFSM()
						BITSET(efMotionTimerEvents[MOTOR_AZIMUTH], EF_MTN_TIMER_25MS_TICK);
					}
					else
					{
						// Azimuth Motion Timer is NOT running
						// make sure event is reset for next use
						BITCLEAR(efMotionTimerEvents[MOTOR_AZIMUTH], EF_MTN_TIMER_25MS_TICK);
					}
					//										uart_send("\r\n5ms tick 4\r\n");
					//-------------------------------
					//	25mS Elevation Motion Timer
					//-------------------------------
					if (IS_BITSET(efMotionTimerEvents[MOTOR_ELEVATION], EF_MTN_TIMER))
					{
						// Elevation motion timer is enabled
						// check for 25mS Motion Timer event overrun
						if (IS_BITSET(efMotionTimerEvents[MOTOR_ELEVATION], EF_MTN_TIMER_25MS_TICK))
						{
							//						RuntimeError(MAIN_ERROR_25MS_MOTION_TICK_OVERRUN);
						}

						// set event flag; processed by MotionFSM()
						BITSET(efMotionTimerEvents[MOTOR_ELEVATION], EF_MTN_TIMER_25MS_TICK);
					}
					else
					{
						// Elevation Motion Timer is NOT running
						// make sure event is reset for next use
						BITCLEAR(efMotionTimerEvents[MOTOR_ELEVATION], EF_MTN_TIMER_25MS_TICK);
					}

					// check for 25mS event overrun
					if (IS_BITSET(efSchedulerEvents, EF_SCHED_25MS_TICK4))
					{
						//					RuntimeError(MAIN_ERROR_25MS_TICK_OVERRUN);
					}

					BITSET(efSchedulerEvents, EF_SCHED_25MS_TICK4);
					e25mSTickState = ST_25mS_TICK4;
					e5mSTickState = ST_5mS_TICK5;			// bump state for next tick
					break;

					//-------------------------------
					//			5mS Tick 5
					//-------------------------------
				case ST_5mS_TICK5:
					// check for 25mS event overrun
					if (IS_BITSET(efSchedulerEvents, EF_SCHED_25MS_TICK5))
					{
						//					RuntimeError(MAIN_ERROR_25MS_TICK_OVERRUN);
					}
					//									uart_send("\r\n5ms tick 5\r\n");
					BITSET(efSchedulerEvents, EF_SCHED_25MS_TICK5);
					e25mSTickState = ST_25mS_TICK5;
					e5mSTickState = ST_5mS_TICK1;			// bump state for next tick
					break;
				}

				//-----------------------------------------------------------------
				// Check for non-timer based events to be processed every 5mS
				//-----------------------------------------------------------------

				// these events should be executed whenever there are non-zero event flags - but not SO often that they completely tie up the system.
				// a sticky (unprocessed) event here will completely kill the system..

#ifdef USE_FEEDBACK_SIMULATOR
				// executes on EVERY 5mS tick
				//-------------------------------
				//		Feedback Simulator
				//-------------------------------
				if (pgwFeedbackSimulatorTickCtr[MOTOR_AZIMUTH] != 0)
				{
					--pgwFeedbackSimulatorTickCtr[MOTOR_AZIMUTH];

					// check for end of count
					if (pgwFeedbackSimulatorTickCtr[MOTOR_AZIMUTH] == 0)
					{
						// counter has expired, so reload the simulated Motion Sensor tick counter
						MS_SetSimulatorTickCtr(MOTOR_AZIMUTH);

						// create a Motion Sensor Feedback pulse
						SetFeedbackSimulator(MOTOR_AZIMUTH);					// feedback pin HIGH
						// Motion Sensor interrupt will occur HERE
						ClearFeedbackSimulator(MOTOR_AZIMUTH);					// feedback pin LOW
					}
				}

				if (pgwFeedbackSimulatorTickCtr[MOTOR_ELEVATION] != 0)
				{
					--pgwFeedbackSimulatorTickCtr[MOTOR_ELEVATION];

					// check for end of count
					if (pgwFeedbackSimulatorTickCtr[MOTOR_ELEVATION] == 0)
					{
						// counter has expired, so reload the simulated Motion Sensor tick counter
						MS_SetSimulatorTickCtr(MOTOR_ELEVATION);

						// create a Motion Sensor Feedback pulse
						SetFeedbackSimulator(MOTOR_ELEVATION);					// feedback pin HIGH
						// Motion Sensor interrupt will occur HERE
						ClearFeedbackSimulator(MOTOR_ELEVATION);				// feedback pin LOW
					}
				}

#endif	//  USE_FEEDBACK_SIMULATOR

				//-------------------------------
				//	MotionPhaseFSM 5mS Call
				//-------------------------------
				// should these be split across 5mS ticks?
#ifdef USE_MOTION_PHASE_FSM_TRIGGER
				Trigger1Level(1);				// trigger to allow viewing this event on a scope
#endif

				if ( ((efMotionResultEvents[MOTOR_AZIMUTH] != NO_EVENTFLAGS) /* || ((efSwitchEvents & EF_SWITCH_UP_AZ_EVENTS_MASK) != (WORD)0) */)
						&& (pgeMotionPhase[MOTOR_AZIMUTH] != PHASE_OPEN_LOOP) )
				{
					MotionPhaseFSM(MOTOR_AZIMUTH);				// event(s) to be processed, so run the Move Command FSM without waiting for the timer
				}

				if ( ((efMotionResultEvents[MOTOR_ELEVATION] != NO_EVENTFLAGS) /* || ((efSwitchEvents & EF_SWITCH_UP_EL_EVENTS_MASK) != (WORD)0) */)
						&& (pgeMotionPhase[MOTOR_ELEVATION] != PHASE_OPEN_LOOP) )
				{
					MotionPhaseFSM(MOTOR_ELEVATION);			// event(s) to be processed, so run the Move Command FSM without waiting for the timer
				}
#ifdef USE_MOTION_PHASE_FSM_TRIGGER
				Trigger1Level(0);				// trigger to allow viewing this event on a scope
#endif

				//-------------------------------
				//		MotionFSM 5mS call
				//-------------------------------
				// should these be split across 5mS ticks?
				// run the MotionFSM second, because it has some slightly sticky events that would prevent the MotionPhaseFSM from running
#ifdef USE_MOTION_FSM_5MS_TRIGGER
				Trigger1Level(1);				// trigger to allow viewing this event on a scope
#endif
				if ( ((efMotionEvents[MOTOR_AZIMUTH] != NO_EVENTFLAGS) /*|| (IsMotionComplete(MOTOR_AZIMUTH) == 0)*/ /*|| (IS_BITSET(efTimerEvents, EF_TIMER_MOTION_25MS_TICK))*/)		// <== kludge?
						&& (pgeMotionPhase[MOTOR_AZIMUTH] != PHASE_OPEN_LOOP) )

				{
					MotionFSM(MOTOR_AZIMUTH);			// event(s) to be processed, so run the Motion FSM without waiting for the timer
				}

				if ( ((efMotionEvents[MOTOR_ELEVATION] != NO_EVENTFLAGS)/* || (IsMotionComplete(MOTOR_ELEVATION) == 0)*/ /* || (IS_BITSET(efTimerEvents, EF_TIMER_MOTION_25MS_TICK))*/)		// <== kludge?
						&& (pgeMotionPhase[MOTOR_ELEVATION] != PHASE_OPEN_LOOP) )
				{
					MotionFSM(MOTOR_ELEVATION);			// event(s) to be processed, so run the Motion FSM without waiting for the timer
				}

			}		// end if (IS_BITSET(efTimerEvents, EF_TIMER_5MS_TICK_INT))
#ifdef USE_MOTION_FSM_5MS_TRIGGER
			Trigger1Level(0);				// trigger to allow viewing this event on a scope
#endif

			//-----------------------------------------------------------------
			//		End of 5ms Events
			//-----------------------------------------------------------------

			//-----------------------------------------------------------------
			//		Handle 25mS Tick events
			//-----------------------------------------------------------------
			// these events are tied to 25mS ticks, and the use of multiple 25mS tick flags forces them to be distributed in time

			//-------------------------------
			//			25mS Tick 1
			//-------------------------------
			// tick:		(efTimerEvents, EF_TIMER_25MS_TICK1)
			// duration:
			// counter:
			// output:
			//				switch (e25mSTickState)
			//				{
			//					case ST_None:
			////						uart_send("\r\n25ms tick none\r\n");
			//						break;
			//					case ST_25mS_TICK1:
			if (IS_BITSET(efSchedulerEvents, EF_SCHED_25MS_TICK1))
			{
				// clear calling event
				BITCLEAR(efSchedulerEvents, EF_SCHED_25MS_TICK1);
#ifdef USE_MENU_FSM_TRIGGER
				Trigger1Level(1);				// trigger to allow viewing this event on a scope
#endif
				//						uart_send("\r\n25ms tick 1\r\n");
#ifdef UART_DUAL_TEST
				MenuFSM();
#endif
#ifdef RXMSG
				//						RxMessageFSM(SERIAL_REMOTE_UART);
#endif
#ifdef BOTH_UARTS
				eSerialOutputMode = SER_MODE_MENU;
				MenuFSM();
				// MenuFSM(SERIAL_REMOTE_UART);
				//				eSerialOutputMode = SER_MODE_MENU;
				//   eSerialOutputMode = SER_MODE_REMOTE;
				//				RxMessageFSM();
#endif
#ifdef USE_MENU_FSM_TRIGGER
				Trigger1Level(0);				// trigger to allow viewing this event on a scope
#endif
				//						break;
				continue;							// we have processed something, so restart at the top of the loop
			}
			//					case ST_25mS_TICK2:
			//-------------------------------
			//			25mS Tick 2
			//-------------------------------
			// enabled by:	none
			// tick:		(efTimerEvents, EF_TIMER_25MS_TICK2)
			// duration:	1 tick
			// counter:		none
			// output:		call MotionFSM

			if (IS_BITSET(efSchedulerEvents, EF_SCHED_25MS_TICK2))
			{

				// bump 100mS tick counter
				fg100mSTimerCount1--;
				//							uart_send("\r\n25ms tick 2\r\n");
				// check for timer complete - or (ACK!) rolled under
				if ((fg100mSTimerCount1 == (unsigned int)0) || (fg100mSTimerCount1 > _100MS_EVENT_PERIOD))
				{
					// no need to check for overrun on 100mS events

					// set event flag
					BITSET(efSchedulerEvents, EF_SCHED_100MS_TICK1);
					e100mSTickState = ST_100mS_TICK1;
					// reload timer
					fg100mSTimerCount1 = _100MS_EVENT_PERIOD;
				}
				// if the MotionPhase is PHASE_OPEN_LOOP, we are running OpenLoop menus selections, so there is no need to run MotionFSM()
				// if the (efMotionTimerEvents[MOTOR_AZIMUTH], EF_MTN_TIMER_25MS_TICK) bit is set, we are ALREADY calling the MotionFSM() on a timed basis on 25mS Tick4, so we can skip this call...  16 Apr 13 <sek>

#ifdef USE_MOTION_FSM_25MS_TRIGGER
				Trigger1Level(1);				// trigger to allow viewing this event on a scope
#endif

				if ((pgeMotionPhase[MOTOR_AZIMUTH] != PHASE_OPEN_LOOP) && (IS_BITCLEAR(efMotionTimerEvents[MOTOR_AZIMUTH], EF_MTN_TIMER_25MS_TICK)))
				{
					// run Motion Control FSM on a timed basis
					MotionFSM(MOTOR_AZIMUTH);
				}

#ifdef USE_ELEVATION
				// if the MotionPhase is PHASE_OPEN_LOOP, we are running OpenLoop menus selections, so there is no need to run MotionFSM()
				// if the (efMotionTimerEvents[MOTOR_AZIMUTH], MOTOR_ELEVATION) bit is set, we are ALREADY calling the MotionFSM() on a timed basis, so we can skip this call...  16 Apr 13 <sek>
				if ((pgeMotionPhase[MOTOR_ELEVATION] != PHASE_OPEN_LOOP) && (IS_BITCLEAR(efMotionTimerEvents[MOTOR_ELEVATION], EF_MTN_TIMER_25MS_TICK)))
				{
					// run Motion Control FSM on a timed basis
					MotionFSM(MOTOR_ELEVATION);
				}
#endif	// USE_ELEVATION

#ifdef USE_MOTION_FSM_25MS_TRIGGER
				Trigger1Level(0);				// trigger to allow viewing this event on a scope
#endif

				// clear calling event
				BITCLEAR(efSchedulerEvents, EF_SCHED_25MS_TICK2);

				//							break;
				continue;				// we have processed something, so restart at the top of the loop
			}

			//					case ST_25mS_TICK3:
			//-------------------------------
			//			25mS Tick 3
			//-------------------------------
			if (IS_BITSET(efSchedulerEvents, EF_SCHED_25MS_TICK3))
			{
				// run Menu FSM on a timed basis
#ifndef UART_TEST
				MenuFSM();
#endif
				//						uart_send("\r\n25ms tick 3\r\n");
				// bump 100mS tick counter
				fg100mSTimerCount2--;

				// check for timer complete - or (ACK!) rolled under
				if ((fg100mSTimerCount2 == (unsigned int)0) || (fg100mSTimerCount2 > _100MS_EVENT_PERIOD))
				{
					// no need to check for overrun on 100mS events

					// set event flag
					BITSET(efSchedulerEvents, EF_SCHED_100MS_TICK2);
					e100mSTickState = ST_100mS_TICK2;
					// reload timer
					fg100mSTimerCount2 = _100MS_EVENT_PERIOD;
				}
				// clear calling event
				BITCLEAR(efSchedulerEvents, EF_SCHED_25MS_TICK3);
				//							break;
				continue;								// we have processed something, so restart at the top of the loop
				// this prevents processing EF_SCHED_25MS_TICK3 and EF_SCHED_100MS_TICK1 on the same 5mS tick
			}
			//					case ST_25mS_TICK4:
			//-------------------------------
			//			25mS Tick 4
			//		Motion Timer Processing
			//-------------------------------
			if (IS_BITSET(efSchedulerEvents, EF_SCHED_25MS_TICK4))
			{
				// bump 100mS tick counter
				fg100mSTimerCount3--;
				//						uart_send("\r\n25ms tick 4\r\n");
				// check for timer complete - or (ACK!) rolled under
				if ((fg100mSTimerCount3 == (unsigned int)0) ||  (fg100mSTimerCount3 > _100MS_EVENT_PERIOD))
				{
					// no need to check for overrun on 100mS events

					// set event flag
					BITSET(efSchedulerEvents, EF_SCHED_100MS_TICK3);
					e100mSTickState = ST_100mS_TICK3;
					// reload timer
					fg100mSTimerCount3 = _100MS_EVENT_PERIOD;
				}

				//-------------------------------
				//	MotionFSM Motion Timer Processing
				//-------------------------------
				// if the MotionPhase is PHASE_OPEN_LOOP, we are running OpenLoop menus selections, so there is no need to run MotionFSM()
				// call MotionFSM() ONLY if the Motion Timer is running
#ifdef USE_MOTION_FSM_TIMER_TRIGGER
				Trigger1Level(1);				// trigger to allow viewing this event on a scope
#endif

				if ( (IS_BITSET(efMotionTimerEvents[MOTOR_AZIMUTH], EF_MTN_TIMER_25MS_TICK)) && (pgeMotionPhase[MOTOR_AZIMUTH] != PHASE_OPEN_LOOP) )
				{
					MotionFSM(MOTOR_AZIMUTH);			// event(s) to be processed, so run the Motion FSM without waiting for the timer
				}

#ifdef USE_ELEVATION
				// perhaps this should be moved to the next 25mS tick?
				if ( (IS_BITSET(efMotionTimerEvents[MOTOR_ELEVATION], EF_MTN_TIMER_25MS_TICK)) && (pgeMotionPhase[MOTOR_ELEVATION] != PHASE_OPEN_LOOP) )
				{
					MotionFSM(MOTOR_ELEVATION);			// event(s) to be processed, so run the Motion FSM without waiting for the timer
				}
#endif	// USE_ELEVATION

#ifdef USE_MOTION_FSM_TIMER_TRIGGER
				Trigger1Level(0);				// trigger to allow viewing this event on a scope
#endif

				// clear calling event
				BITCLEAR(efSchedulerEvents, EF_SCHED_25MS_TICK4);
				//							break;
				continue;								// we have processed something, so restart at the top of the loop
				// this prevents processing EF_SCHED_25MS_TICK4 and EF_SCHED_100MS_TICK2 on the same 5mS tick
			}
			//					case ST_25mS_TICK5:
			//-------------------------------
			//			25mS Tick 5
			//-------------------------------
			if (IS_BITSET(efSchedulerEvents, EF_SCHED_25MS_TICK5))
			{
				// bump 100mS tick counter
				fg100mSTimerCount4--;
				//						uart_send("\r\n25ms tick 5\r\n");
				// check for timer complete - or (ACK!) rolled under
				if ((fg100mSTimerCount4 == (unsigned int)0) ||  (fg100mSTimerCount4 > _100MS_EVENT_PERIOD))
				{
					// no need to check for overrun on 100mS events

					// set event flag
					BITSET(efSchedulerEvents, EF_SCHED_100MS_TICK4);
					e100mSTickState = ST_100mS_TICK4;
					// reload timer
					fg100mSTimerCount4 = _100MS_EVENT_PERIOD;
				}
				// clear calling event
				BITCLEAR(efSchedulerEvents, EF_SCHED_25MS_TICK5);
				//						break;
				continue;									// we have processed something, so restart at the top of the loop
				// this prevents processing EF_SCHED_25MS_TICK5 and EF_SCHED_100MS_TICK3 on the same 5mS tick
			}
			//-----------------------------------------------------------------
			//		Handle 100mS Tick events
			//-----------------------------------------------------------------
			//				switch (e100mSTickState)
			//				{
			//					case None:
			//						break;
			//					case ST_100mS_TICK1:

			if (IS_BITSET(efSchedulerEvents, EF_SCHED_100MS_TICK1))
			{
#ifdef USE_MOVE_SEQ_TICK_TRIGGER
				Trigger1Level(1);						// trigger to allow viewing this event on a scope
#endif
				//						uart_send("\r\n100ms tick 1\r\n");
				MoveSequenceTick();							// MoveSequenceFSM Timers()
#ifdef USE_MOVE_SEQ_TICK_TRIGGER
				Trigger1Level(0);						// trigger to allow viewing this event on a scope
#endif


#ifdef USE_BUTTON_PROC_FSM_TRIGGER
				//							Trigger1Level(1);						// trigger to allow viewing this event on a scope
#endif

#ifdef SWITCH_INIT
				Switch_processing();
#endif

				//						ButtonProcessingFSM();

#ifdef USE_BUTTON_PROC_FSM_TRIGGER
				//							Trigger1Level(0);						// trigger to allow viewing this event on a scope
#endif

#ifdef USE_HARD_STALL_RESET_TIMER
				// handle Hard Stall Reset Delay Timer
				if (IS_BITSET(efTimerEvents, EF_TIMER_HARD_STALL))
				{
					// Hard Stall Reset Delay timer is enabled

					// bump Hard Stall Reset Delay timer
					fgHardStallResetDelayTimerCount--;

					if ( fgHardStallResetDelayTimerCount == 0 )
					{
						// Hard Stall has timed out, reset MCU
						Reset();							// reset MCU
					}
				}
				else
				{
					// make sure timer is reset for next use
					fgHardStallResetDelayTimerCount = _15S_EVENT_PERIOD;
					BITCLEAR(efTimerEvents, EF_TIMER_HARD_STALL_TIMEOUT);
				}
#endif

				// clear calling event flag
				BITCLEAR(efSchedulerEvents, EF_SCHED_100MS_TICK1);
				//						break;
				continue;									// we have processed something, so restart at the top of the loop
			}



			//					case ST_100mS_TICK2:
			if (IS_BITSET(efSchedulerEvents, EF_SCHED_100MS_TICK2))
			{
#ifdef USE_MOVE_SEQ_FSM_TRIGGER
				Trigger1Level(1);						// trigger to allow viewing this event on a scope
#endif
				//						uart_send("\r\n100ms tick 2\r\n");
				if ((efMoveSequenceEvents != NO_EVENTFLAGS) || (IsMoveSequenceComplete() == 0))
					MoveSequenceFSM();
				if ((efMoveSequenceEvents != NO_EVENTFLAGS) || (IsMoveSequenceComplete() == 0) ||(IS_BITSET(efPanelPositionEvents, EF_PANEL_POS_WIND_STOW))||(IS_BITSET(efPanelPositionEvents, EF_PANEL_POS_END_WIND_STOW)))
					//					MoveSequenceFSM();
#ifdef USE_MOVE_SEQ_FSM_TRIGGER
					Trigger1Level(0);						// trigger to allow viewing this event on a scope
#endif

				// clear calling event flag
				BITCLEAR(efSchedulerEvents, EF_SCHED_100MS_TICK2);
				//						break;
				continue;									// we have processed something, so restart at the top of the loop
			}


			//					case ST_100mS_TICK3:
			if (IS_BITSET(efSchedulerEvents, EF_SCHED_100MS_TICK3))
			{
				// run event
#ifdef USE_MOTION_PHASE_FSM_TRIGGER
				Trigger1Level(1);				// trigger to allow viewing this event on a scope
#endif
				//						uart_send("\r\n100ms tick 3\r\n");
				if ( ((efMotionPhaseCommands[MOTOR_AZIMUTH] != NO_EVENTFLAGS) || (IsCommandComplete(MOTOR_AZIMUTH) == 0))
						&& (pgeMotionPhase[MOTOR_AZIMUTH] != PHASE_OPEN_LOOP) )
				{
					MotionPhaseFSM(MOTOR_AZIMUTH);
				}

				if ( ((efMotionPhaseCommands[MOTOR_ELEVATION] != NO_EVENTFLAGS) || (IsCommandComplete(MOTOR_ELEVATION) == 0))
						&& (pgeMotionPhase[MOTOR_ELEVATION] != PHASE_OPEN_LOOP) )
				{
					MotionPhaseFSM(MOTOR_ELEVATION);
				}

#ifdef USE_MOTION_PHASE_FSM_TRIGGER
				Trigger1Level(0);				// trigger to allow viewing this event on a scope
#endif

				// UART tests, intended for inital testing of new hardware
#ifdef UART_TEST
				StartTransmitString(SERIAL_MENU_UART, "This is a test!");
#endif

				// clear calling event flag
				BITCLEAR(efSchedulerEvents, EF_SCHED_100MS_TICK3);
				//						break;
				continue;				// we have processed something, so restart at the top of the loop
			}
			//					case ST_100mS_TICK4:
			if (IS_BITSET(efSchedulerEvents, EF_SCHED_100MS_TICK4))
			{
				// clear calling event flag
				BITCLEAR(efSchedulerEvents, EF_SCHED_100MS_TICK4);
				//						uart_send("\r\n100ms tick 4\r\n");
				// run event
#ifdef USE_MOTION_PHASE_FSM_TRIGGER
				Trigger1Level(1);				// trigger to allow viewing this event on a scope
#endif

#if defined(USE_SINGLE_POLAR_AXIS) && defined(USE_INCLINOMETER_FEEDBACK)

				// read accelerometer values
				if (ReadInclinometerSample(&pgInclination) == TRUE)							// read accelerometer, calculate 3D angles
				{
					fgbI2CErrorCtr = 0;
					fgbI2CHrdStlCtr  = 0;
					IGNORE_RETURN_VALUE AverageInclinometerSample(&pgInclination);			// add to averaging array, calculate new running average
					//check beyond limits in both Manual and Auto for extreme cases
					if(fgdefferenceAngle = fabs(pgAngleAverage.fX_Angle) >= EXTREME_ANGLES)
					{
						ClearCommandStarted(MOTOR_AZIMUTH);
#if defined(USE_MOVE_SEQ_FSM_STEP_VERBOSE)
						//						DisplayMessage(SERIAL_MENU_UART,"\r\nReached setpont\r\n", WAIT_FOR_DISPLAY);
#endif
						Finish_MotionStats(MOTOR_AZIMUTH);
						Transmit("Main.c: Line 1072\n", 18);
						// ==>> does the previous command ever get completed?
						SetCommandStarted(MOTOR_AZIMUTH);								// mark command as started so we cannot misinterpret completion
						BITSET(efMotionPhaseCommands[MOTOR_AZIMUTH], EF_MTN_CMD_STOP);	// bring to an orderly stop
						ResetMotionFSM();
						//								break;
						continue;
					}

					// EF_MOTION_SENSOR_ACTIVE is set when the PWM is configured for FORWARD or REVERSE, before the start of motion
					// EF_MOTION_SENSOR_ACTIVE is cleared when MotionFSM.c: MotionFSM() enters ST_MOTION_STOPPED for the first time
					// so this will only execute DURING a move, and NOT when stopped.
					if(IS_BITSET(efMotionSensorEvents[MOTOR_AZIMUTH], EF_MOTION_SENSOR_ACTIVE) IS_TRUE)
					{
						if(ptrRAM_SystemParameters->ucTracking_Mode == MODE_TRACKING)
						{
							if(bTrackerDirection == 1)
							{
								if(((fgdefferenceAngle = fabs(pgAngleAverage.fX_Angle-(ptrRTCC_RAM_AppParameters->fSetPoint_AZ))) <= MIN_FLUCT_ANGLE)
										||(pgAngleAverage.fX_Angle >= (ptrRAM_SystemParameters->fSingle_SoftLimit_Forward - MIN_FLUCT_ANGLE)))
								{
									ClearCommandStarted(MOTOR_AZIMUTH);
#if defined(USE_MOVE_SEQ_FSM_STEP_VERBOSE)
									//									DisplayMessage(SERIAL_MENU_UART,"\r\nReached setpont\r\n", WAIT_FOR_DISPLAY);
#endif
									Finish_MotionStats(MOTOR_AZIMUTH);
									Transmit("Main.c: Line 1098\n", 18);
									// ==>> does the previous command ever get completed?
									SetCommandStarted(MOTOR_AZIMUTH);								// mark command as started so we cannot misinterpret completion
									BITSET(efMotionPhaseCommands[MOTOR_AZIMUTH], EF_MTN_CMD_STOP);	// bring to an orderly stop
									ResetMotionFSM();
									//											break;
									continue;
								}
							}
							else if(bTrackerDirection == 2)
							{
								if(((fgdefferenceAngle = fabs(pgAngleAverage.fX_Angle-(ptrRTCC_RAM_AppParameters->fSetPoint_AZ))) <= MIN_FLUCT_ANGLE)
										||(pgAngleAverage.fX_Angle <= (ptrRAM_SystemParameters->fSingle_SoftLimit_Reverse + MIN_FLUCT_ANGLE)))
								{
									ClearCommandStarted(MOTOR_AZIMUTH);
#if defined(USE_MOVE_SEQ_FSM_STEP_VERBOSE)
									//									DisplayMessage(SERIAL_MENU_UART,"\r\nReached setpont\r\n", WAIT_FOR_DISPLAY);
#endif
									Finish_MotionStats(MOTOR_AZIMUTH);
									Transmit("Main.c: Line 1116\n", 18);
									// ==>> does the previous command ever get completed?
									SetCommandStarted(MOTOR_AZIMUTH);								// mark command as started so we cannot misinterpret completion
									BITSET(efMotionPhaseCommands[MOTOR_AZIMUTH], EF_MTN_CMD_STOP);	// bring to an orderly stop
									ResetMotionFSM();
									//											break;
									continue;
								}
							}
						}                                                                                                                // clear error counter; we are only interested in consecutive errors
						else
						{
							if(MAN_STOW == 1)
							{
								if((pgAngleAverage.fX_Angle <= (ptrRAM_SystemParameters->fSingle_SoftLimit_Reverse + MIN_MANUAL_ANGLE))
										||(pgAngleAverage.fX_Angle >= (ptrRAM_SystemParameters->fSingle_SoftLimit_Forward - MIN_MANUAL_ANGLE))
										||((int)pgAngleAverage.fX_Angle == 0))
								{
									MAN_STOW = 0;
									ClearCommandStarted(MOTOR_AZIMUTH);
#if defined(USE_MOVE_SEQ_FSM_STEP_VERBOSE)
									//									DisplayMessage(SERIAL_MENU_UART,"Reached setpont", NO_WAIT_FOR_DISPLAY);
#endif
									Finish_MotionStats(MOTOR_AZIMUTH);
									Transmit("Main.c: Line 1141\n", 18);
									// ==>> does the previous command ever get completed?
									// mark command as started so we cannot misinterpret completion
									BITSET(efMotionPhaseCommands[MOTOR_AZIMUTH], EF_MTN_CMD_STOP);	// bring to an orderly stop
									ResetMotionFSM();
									//											break;
									continue;
								}
							}
							else if(MAN_EAST == 1)
							{
								if((pgAngleAverage.fX_Angle <= (ptrRAM_SystemParameters->fSingle_SoftLimit_Reverse + MIN_MANUAL_ANGLE)))
								{
									MAN_EAST = 0;
									ClearCommandStarted(MOTOR_AZIMUTH);
#if defined(USE_MOVE_SEQ_FSM_STEP_VERBOSE)
									//									DisplayMessage(SERIAL_MENU_UART,"\r\nReached setpont\r\n", WAIT_FOR_DISPLAY);
#endif
									Finish_MotionStats(MOTOR_AZIMUTH);
									Transmit("Main.c: Line 1158\n", 18);
									// mark command as started so we cannot misinterpret completion
									BITSET(efMotionPhaseCommands[MOTOR_AZIMUTH], EF_MTN_CMD_STOP);	// bring to an orderly stop
									ResetMotionFSM();
									//											break;
									continue;
								}
							}
							else if(MAN_WEST == 1)
							{
								if((pgAngleAverage.fX_Angle >= (ptrRAM_SystemParameters->fSingle_SoftLimit_Forward - MIN_MANUAL_ANGLE)))
								{
									MAN_WEST = 0;
									ClearCommandStarted(MOTOR_AZIMUTH);
#if defined(USE_MOVE_SEQ_FSM_STEP_VERBOSE)
									//									DisplayMessage(SERIAL_MENU_UART,"\r\nReached setpont\r\n", WAIT_FOR_DISPLAY);
#endif
									Finish_MotionStats(MOTOR_AZIMUTH);
									Transmit("Main.c: Line 1175\n", 18);
									BITSET(efMotionPhaseCommands[MOTOR_AZIMUTH], EF_MTN_CMD_STOP);	// bring to an orderly stop
									ResetMotionFSM();
									//											break;
									continue;
								}
							}
						}
						BITSET(efMotionSensorEvents[MOTOR_AZIMUTH], EF_MOTION_SENSOR_TICK);
					}
				}
				else
				{
					// bump I2C error counter
					///RuntimeError(INCLINOMETER_ERROR_READ_FAIL);
					if (fgbI2CErrorCtr == MAX_I2C_ERROR_CNT)								// if too many consecutive errors, stop motor (see inclinometer.h)
					{
						fgbI2CErrorCtr = 0;
						ClearCommandStarted(MOTOR_AZIMUTH);
						MAN_EAST = MAN_WEST = 0;
						Finish_MotionStats(MOTOR_AZIMUTH);
						Transmit("Main.c: Line 1197\n", 18);
						// ==>> does the previous command ever get completed?
						SetCommandStarted(MOTOR_AZIMUTH);								// mark command as started so we cannot misinterpret completion
						BITSET(efMotionPhaseCommands[MOTOR_AZIMUTH], EF_MTN_CMD_STOP);	// bring to an orderly stop
						++fgbI2CHrdStlCtr;
#ifdef MAIN_DEBUG
						DisplayStrSequence(SERIAL_MENU_UART, "Inclinometer fail, soft stall Stop .....");
#endif
						ResetMotionFSM();
					}
					else
					{
						if(fgbI2CHrdStlCtr != MAX_I2C_HrdStal_CNT)
						{
							// inclinometer read error/failure
							++fgbI2CErrorCtr;
							//									I2CReset();
#ifdef MAIN_DEBUG
							DisplayStrSequence(SERIAL_MENU_UART, "Inclinometer Read Failure,i2c reset");
#endif
						}
						else
						{
							fgbI2CHrdStlCtr = 0;
							fgbI2CErrorCtr =0;
							//????
							//BITSET(efMotionResultEvents[MOTOR_AZIMUTH], EF_RESULT_HARD_STALL);
#ifdef MAIN_DEBUG
							DisplayStrSequence(SERIAL_MENU_UART, "Inclinometer fail,hard stall Stop .....");
#endif
						}
					}
				}

#endif	//  defined(USE_SINGLE_POLAR_AXIS) && defined(USE_INCLINOMETER_FEEDBACK)

#ifdef USE_MOTION_PHASE_FSM_TRIGGER
				Trigger1Level(0);				// trigger to allow viewing this event on a scope
#endif
				//					break;
				continue;				// we have processed something, so restart at the top of the loop
			}

		}
    /* USER CODE BEGIN 3 */
	}
  /* USER CODE END 3 */
}

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
