konaiahgari-nithish-reddy/base_text/edge-firmware-BaseCode/Stm32U5TrackerEnable/Core/Inc/Tracker/MotionFSM.h

// *************************************************************************************************
//										M o t i o n F S M . H
// *************************************************************************************************
//
//		Project:	SmartTrak Solar Panel Controller
//
//		Contains:	Motion Control FSM function prototypes, definitions
//
// *************************************************************************************************

#ifndef MOTIONFSM_H
	#define MOTIONFSM_H
#endif

#ifndef MOTORPWM_H
	#error MotorPWM.h must be #included first
#endif


//-------------------------------------------------------------------------------------------------------
// Definitions
//-------------------------------------------------------------------------------------------------------

// Motion Control FSM states
enum tagMotionStates
{
    ST_MOTION_INIT,				// initial state, only at power up

    ST_MOTION_STOPPED,			// all motion stopped

    ST_MOTION_ACCELERATE,		// accelerate by increasing PWM
    ST_MOTION_ACC_INCREASE_PWM,	// increase PWM to speed up
    ST_MOTION_ACC_DECREASE_PWM,	// decrease PWM to slow down (?)
    ST_MOTION_CONSTANT_SPEED,	// constant speed, constant PWM
    ST_MOTION_CON_INCREASE_PWM,	// accelerate PWM to overcome load and maintain constant speed
    ST_MOTION_CON_DECREASE_PWM,	// decrease PWM to slow down (?)
    ST_MOTION_DECELERATE,		// decelerate by reducing PWM
    ST_MOTION_MINIMUM_PWM,		// constant speed at minimum PMW
	ST_MOTION_COASTING,

    ST_MOTION_SOFT_STALL,		// stall recovery state
    ST_MOTION_HARD_STALL		// stall error state

};


// Motion Type
enum tagMotionTypes
{
	MOTION_INIT,				// initial state, only at power up

	MOTION_STOPPED,				// motion has actually STOPPED (quadrature encoder timeout)
	MOTION_STARTING,			// PWM is on, but no MSI ticks yet
	MOTION_POWERED,				// motor is ON
	MOTION_COASTING,			// motor is OFF, some coasting MAY occur
	MOTION_BRAKING,				// motor is OFF, PWM shorted to act as electric brake

	MOTION_STALLED				// system has STALLED; no exit
};
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
