konaiahgari-nithish-reddy/base_text/(notices)

Notices in the files:
edge-firmware-BaseCode/Stm32U5TrackerEnable/Core/Inc/main.h:
Copyright (c) 2023 STMicroelectronics.
All rights reserved.
This software is licensed under terms that can be found in the LICENSE file
